praimondo1970-MyGit/SmartKiln-Firmware/assets/SmartKiln_UI_Guia_Estilo.pdf

## Guía de Estilo – Interfaz SmartKiln

### Paleta de Colores

La interfaz combina tonos oscuros con acentos cálidos y contrastantes. Se prioriza la legibilidad y el aspecto profesional.
Color | Código HEX | Uso
Fondo principal | #0D1117 | Color de fondo general
Tarjeta | #161B22 | Panel o tarjeta de información
Texto principal | #FFFFFF | Datos principales (temperatura, títulos)
Texto secundario | #A1A1A1 | Subtítulos, etiquetas
Acento (naranja) | #FF6B2C | Indicadores activos y barras de progreso
Acento alternativo (azul) | #0094FF | Modo alternativo o estado neutro

### Tipografía

Fuente principal: **Poppins / Montserrat** (sans-serif). Elegida por su legibilidad y estilo moderno, con curvas suaves que acompañan el diseño minimalista.
- Títulos y encabezados: Poppins Bold, 20–24 pt • Texto principal: Poppins Regular, 14–16 pt • Texto secundario o etiquetas: Poppins Light, 12–14 pt

### Componentes y Estructura Visual

- Tarjetas con bordes redondeados (radio: 10–12 px) y sombra sutil. • Gráficos de progreso circulares y lineales con degradado suave. • Iconografía monocromática en escala de grises. • Distribución: panel superior con nombre del dispositivo e íconos de conexión, zona central con temperatura y estado, zona inferior con detalles del proceso.

### Recomendaciones de Uso

- Mantener el contraste entre texto y fondo para asegurar la legibilidad. • Utilizar los colores de acento solo para destacar elementos clave. • Respetar márgenes y proporciones para preservar el equilibrio visual. • Preferir íconos minimalistas y consistentes con la paleta general.
