praimondo1970-MyGit/SmartKiln-Firmware/Circuito de Potencia/Conexiones_Fisicas_Potencia.png

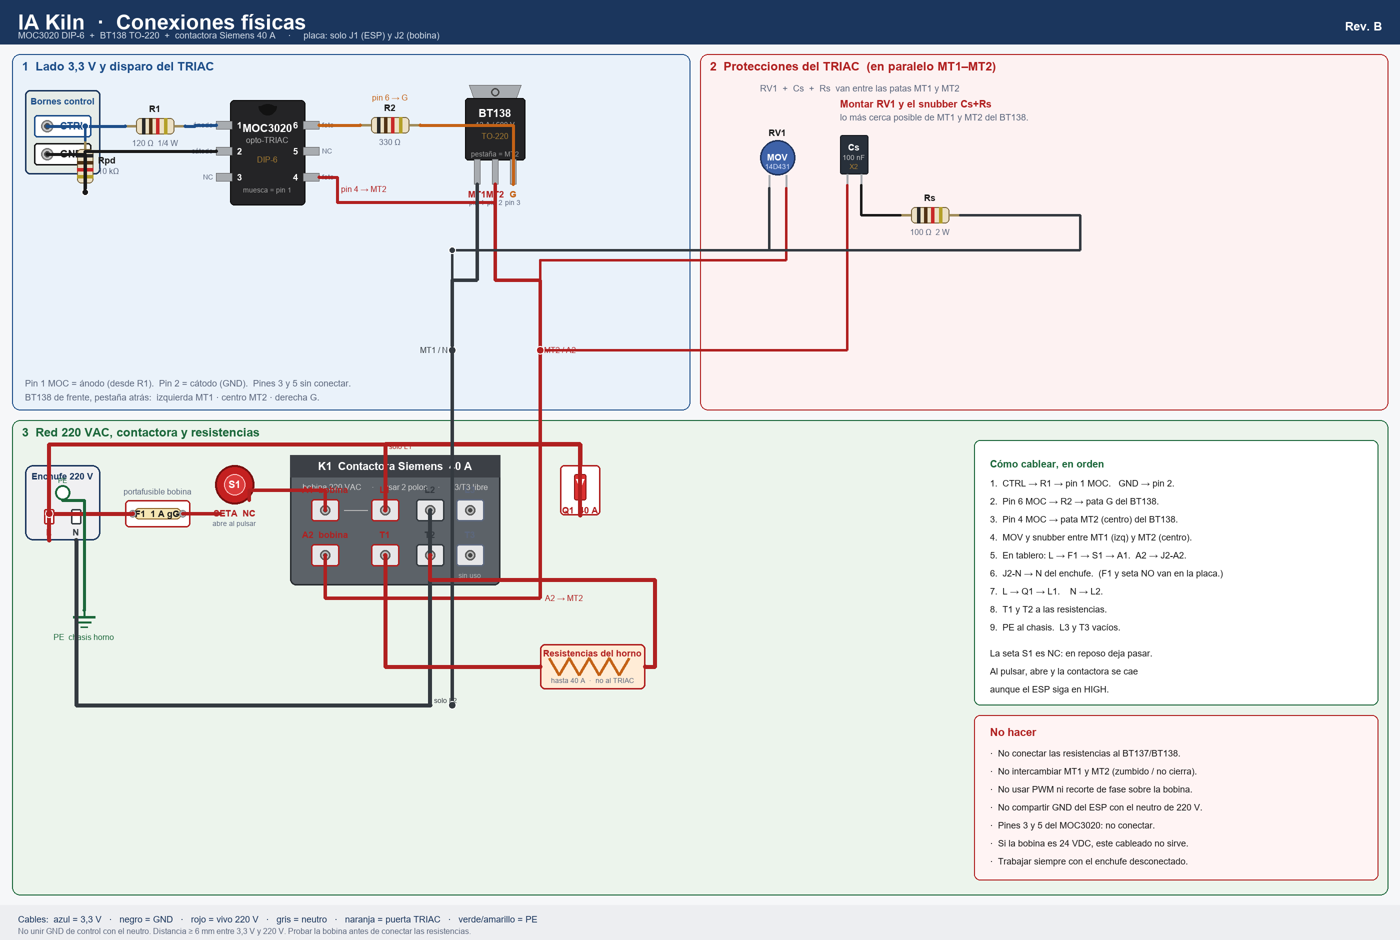
Circuito de Potencia/Conexiones_Fisicas_Potencia.png
