praimondo1970-MyGit/SmartKiln-Firmware/Display/c__Users_praim_AppData_Roaming_Cursor_User_workspaceStorage_e96c1dd4c59a7dd403c3e120ff3f4726_images_smartkiln-display-mockup-v2-dashboard-1fecc456-dbc0-4168-bc59-79bc5c1a509b.jpg

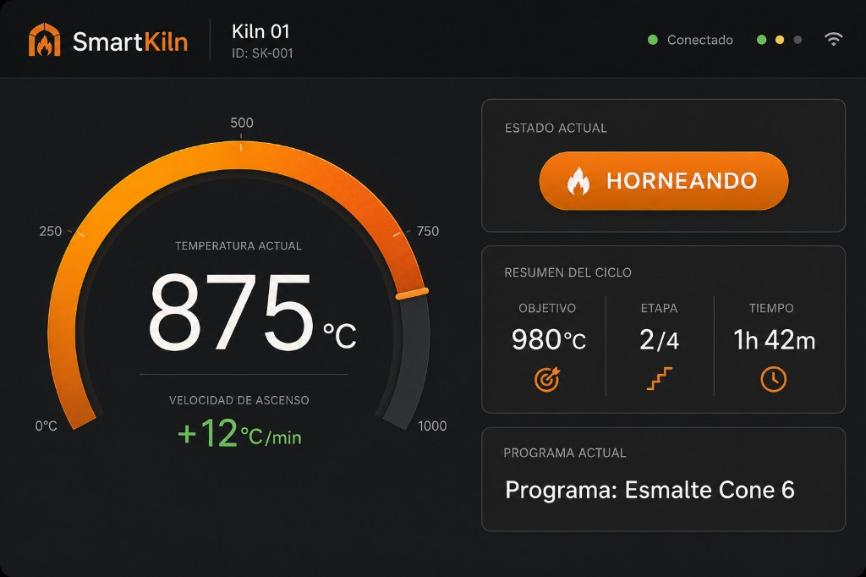
Display/c__Users_praim_AppData_Roaming_Cursor_User_workspaceStorage_e96c1dd4c59a7dd403c3e120ff3f4726_images_smartkiln-display-mockup-v2-dashboard-1fecc456-dbc0-4168-bc59-79bc5c1a509b.jpg
