praimondo1970-MyGit/SmartKiln-Firmware/Display/FINAL - Display.png

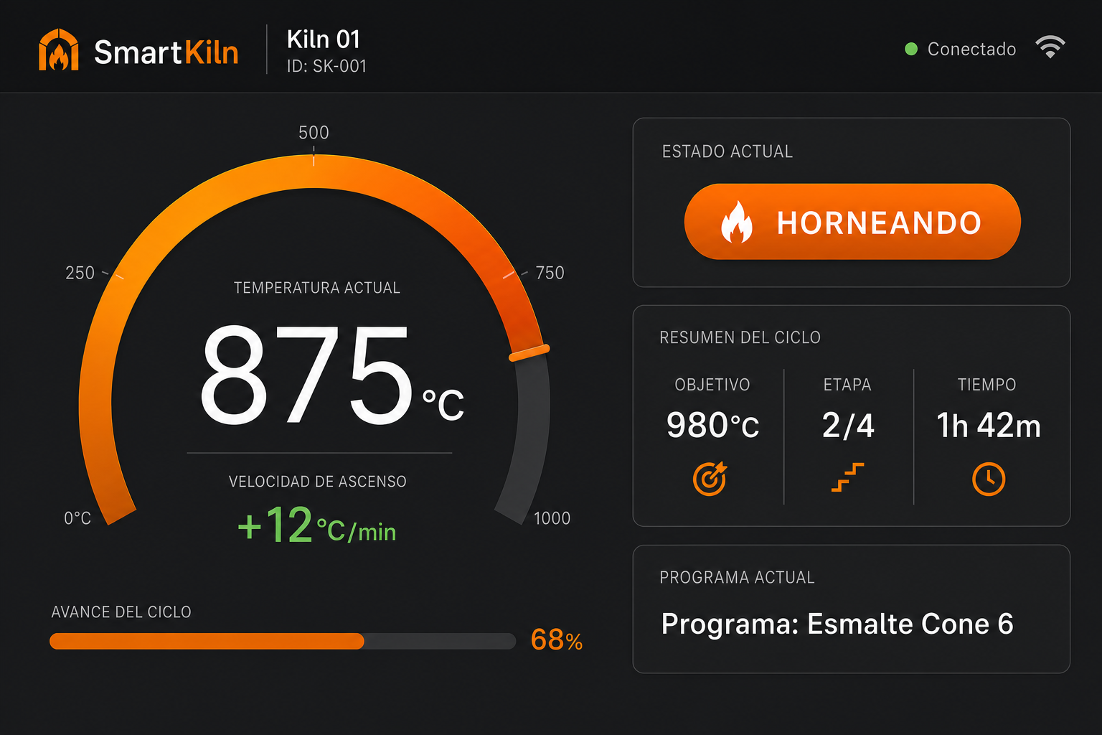
Display/FINAL - Display.png
