praimondo1970-MyGit/SmartKiln-Firmware/Display/FINAL - Inicio.png

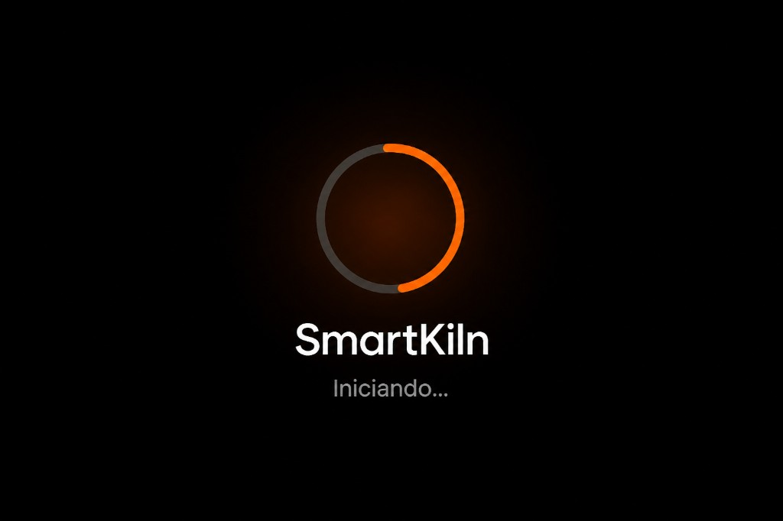
Display/FINAL - Inicio.png
