praimondo1970-MyGit/SmartKiln-Firmware/Display/smartkiln-display-mockup-v1-main.png

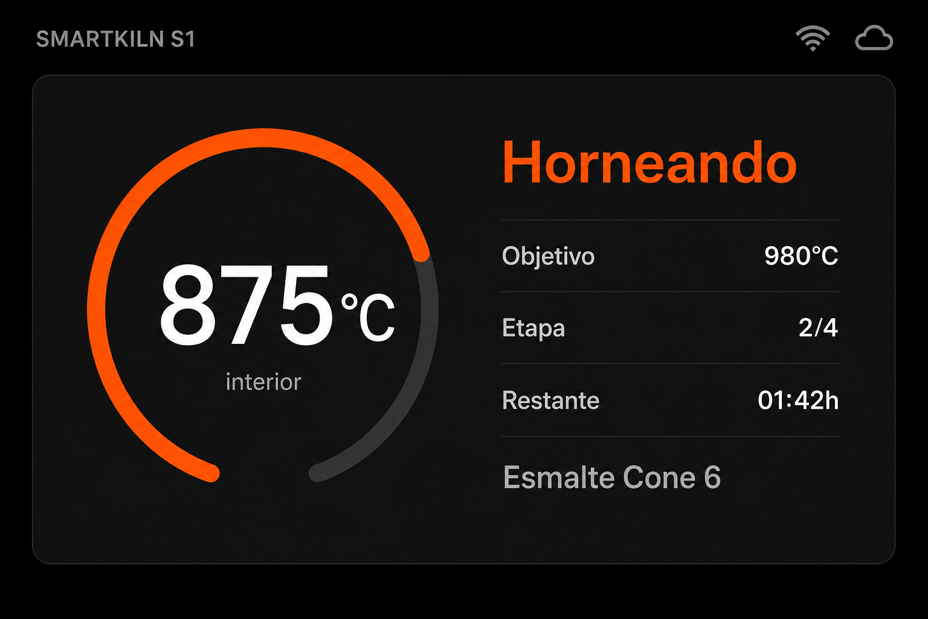
Display/smartkiln-display-mockup-v1-main.png
