praimondo1970-MyGit/SmartKiln-Firmware/Display/smartkiln-display-mockup-v2-dashboard.png

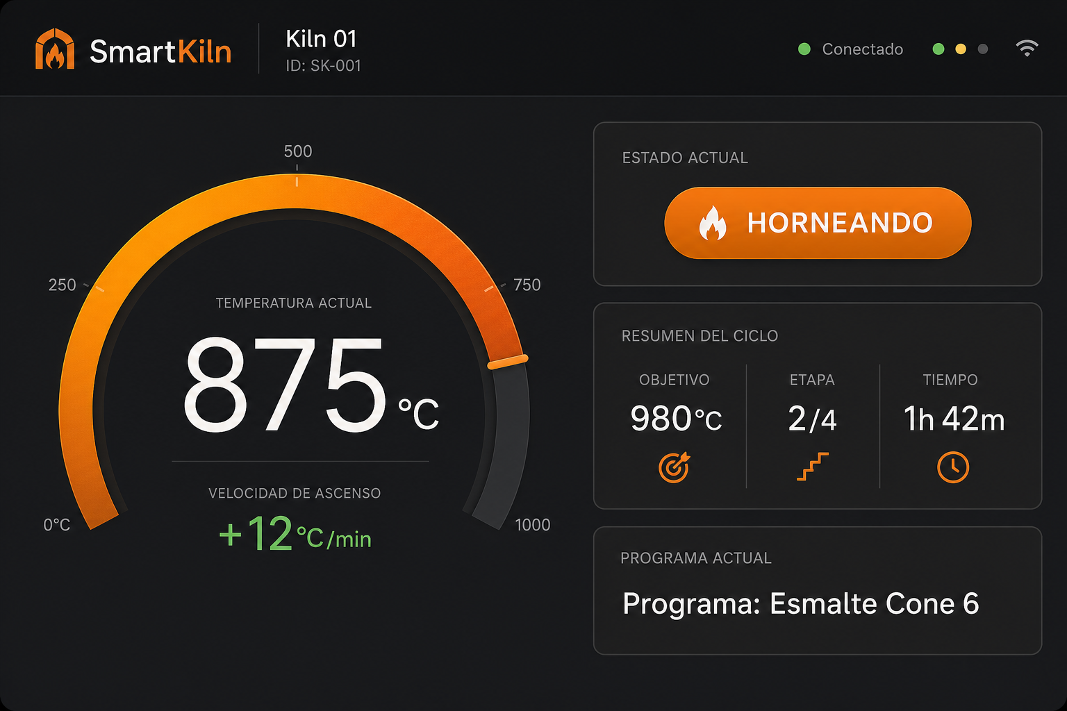
Display/smartkiln-display-mockup-v2-dashboard.png
