praimondo1970-MyGit/SmartKiln-Firmware/Display/smartkiln-display-mockup-v2-final-progress-compact.png

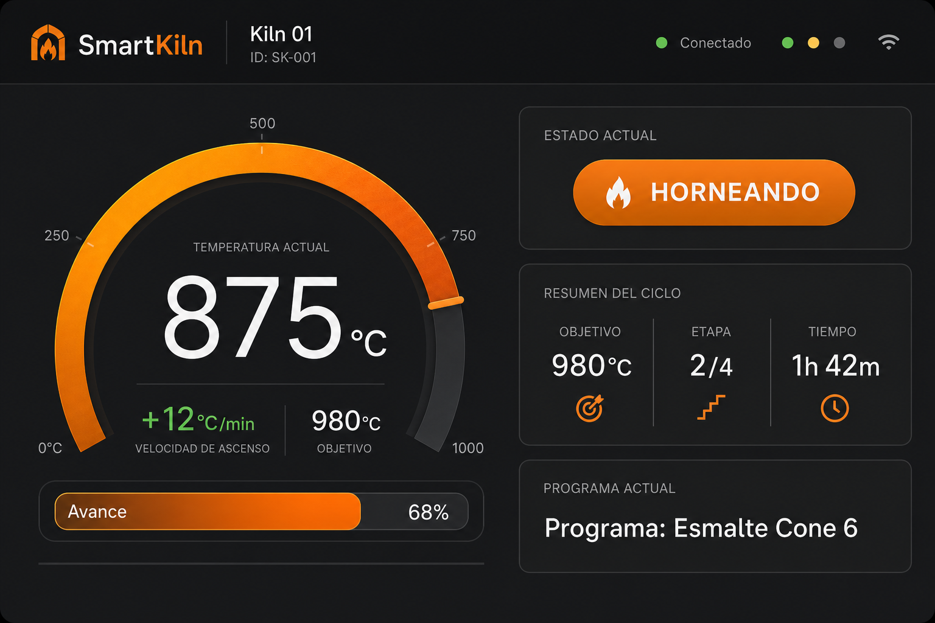
Display/smartkiln-display-mockup-v2-final-progress-compact.png
