praimondo1970-MyGit/SmartKiln-Firmware/Display/smartkiln-display-mockup-v2b-semicircle-cards.png

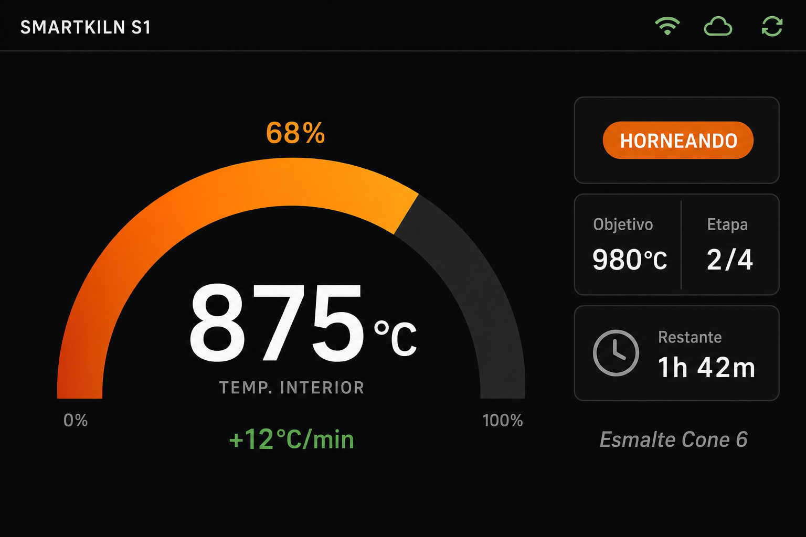
Display/smartkiln-display-mockup-v2b-semicircle-cards.png
