praimondo1970-MyGit/SmartKiln-Firmware/Display/smartkiln-display-mockup-v2c-tiles-hero.png

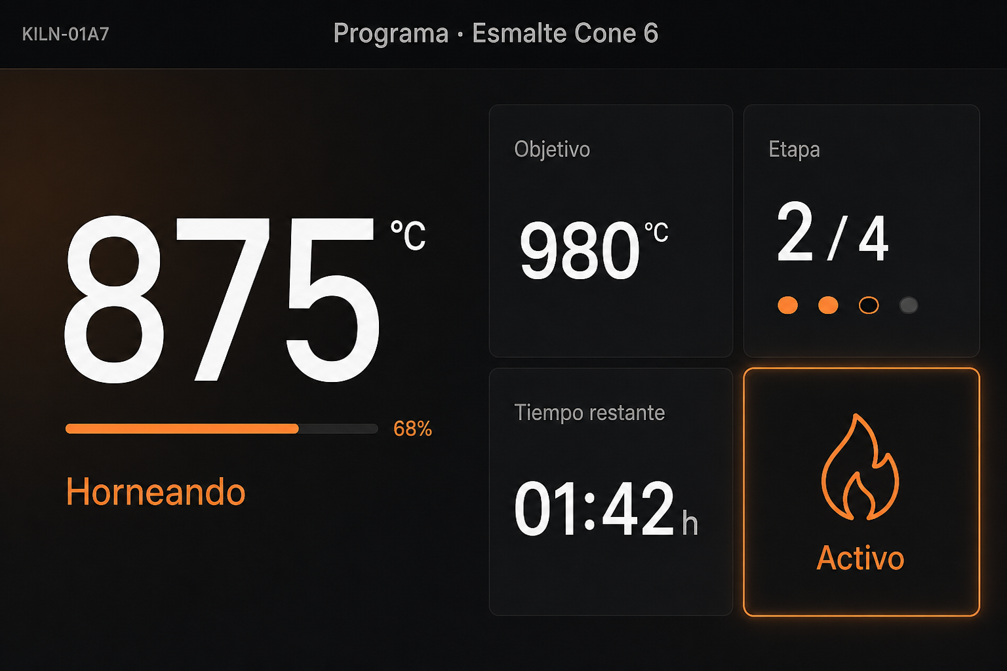
Display/smartkiln-display-mockup-v2c-tiles-hero.png
