praimondo1970-MyGit/SmartKiln-Firmware/docs/IA_Kiln_Driver_Cotas_1a1.png

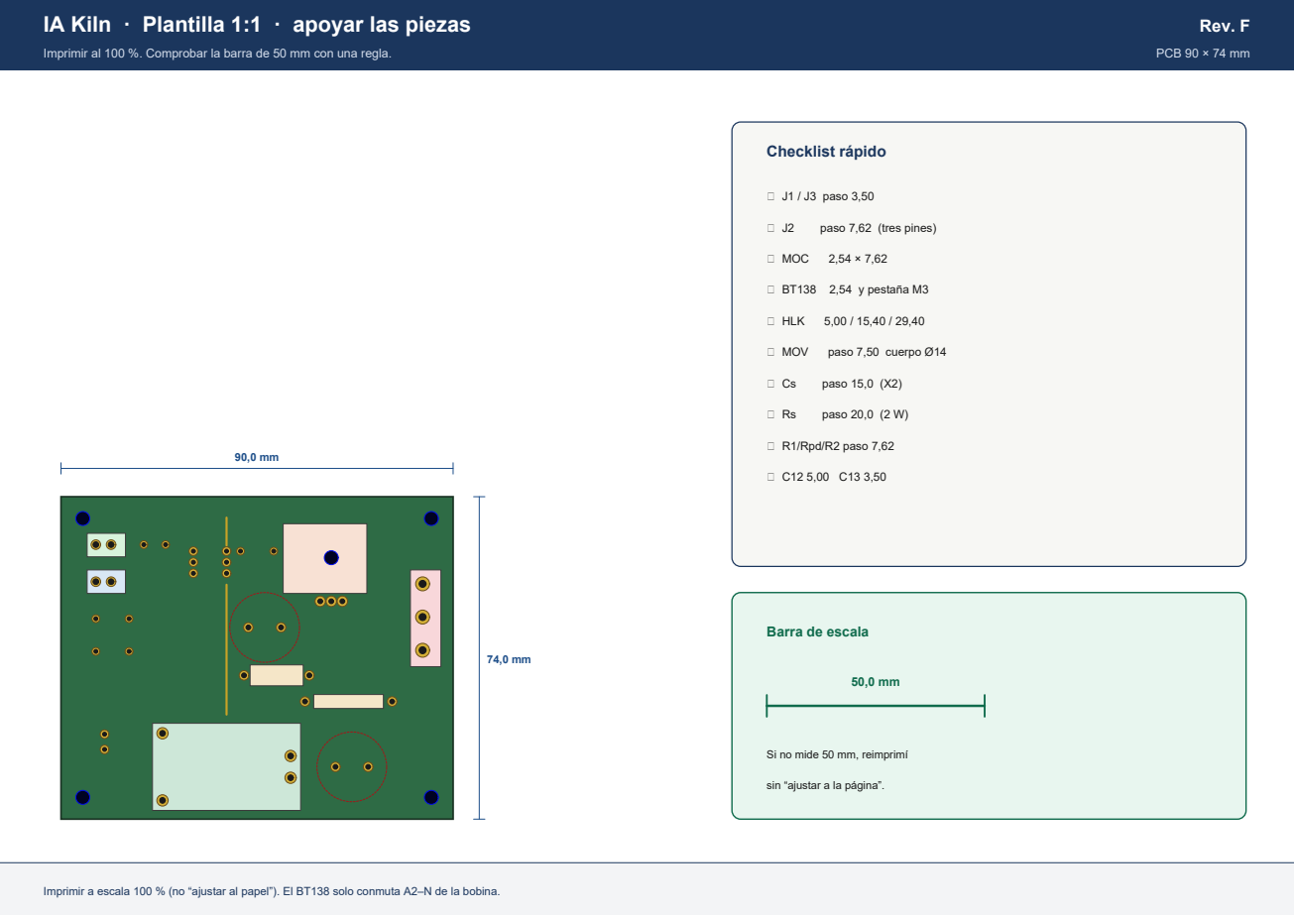
docs/IA_Kiln_Driver_Cotas_1a1.png
