praimondo1970-MyGit/SmartKiln-Firmware/docs/IA_Kiln_Driver_Cotas_2026-09-06_p2.png

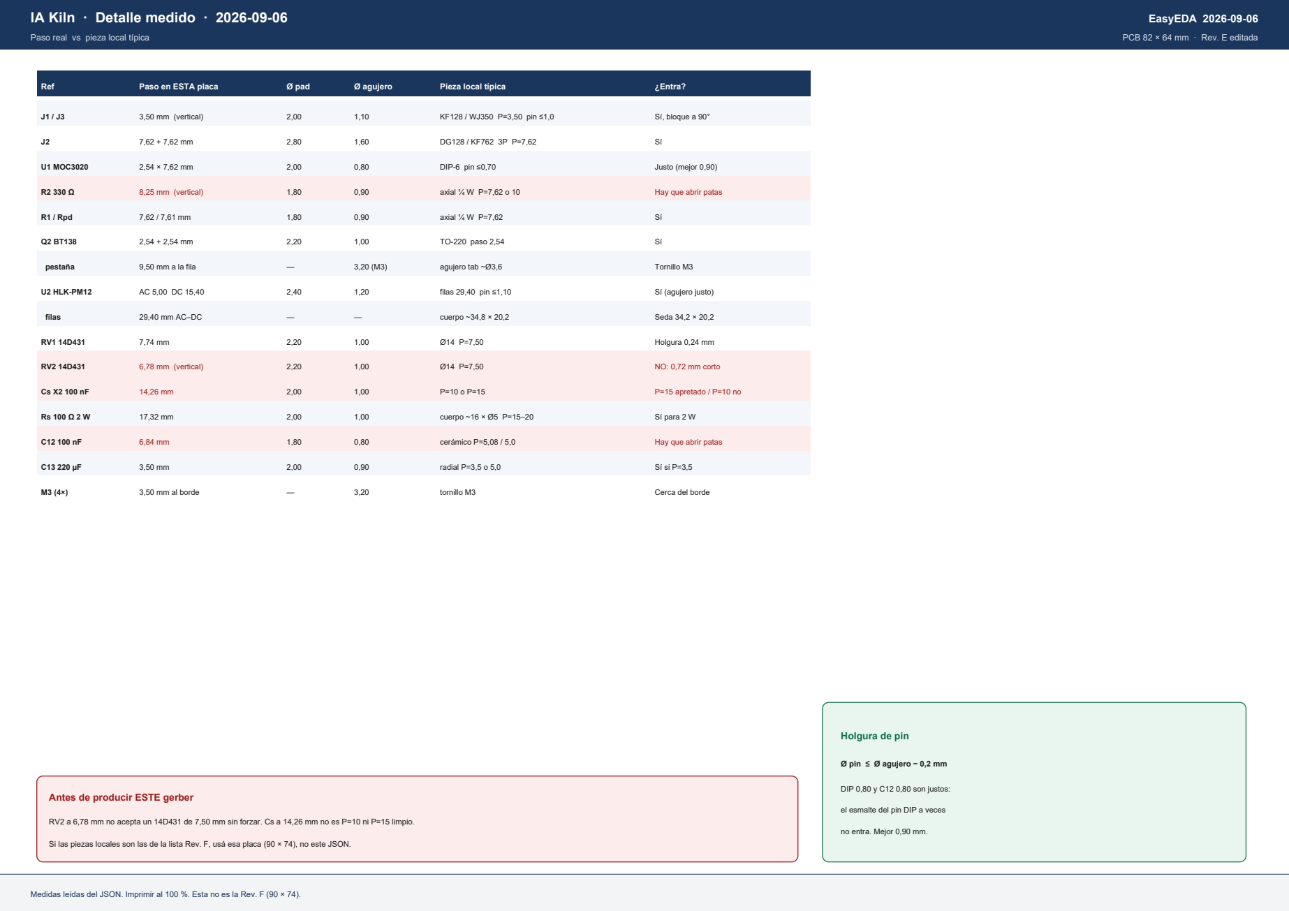
docs/IA_Kiln_Driver_Cotas_2026-09-06_p2.png
