praimondo1970-MyGit/SmartKiln-Firmware/docs/IA_Kiln_Driver_Esquema_p1.png

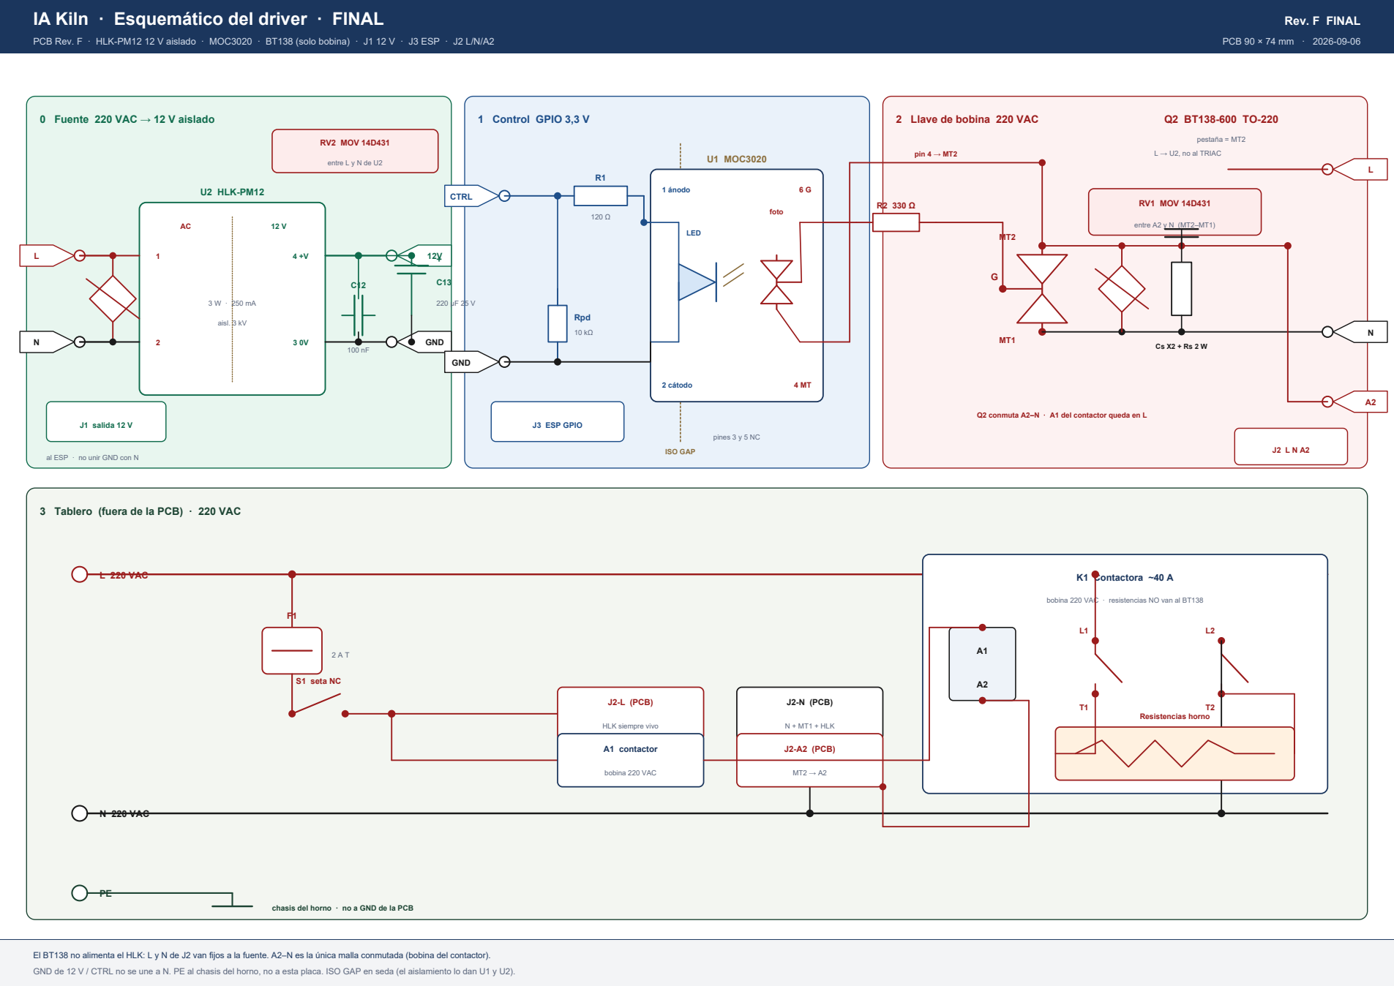
docs/IA_Kiln_Driver_Esquema_p1.png
