praimondo1970-MyGit/SmartKiln-Firmware/pcb/IA_Kiln_Driver_3D.png

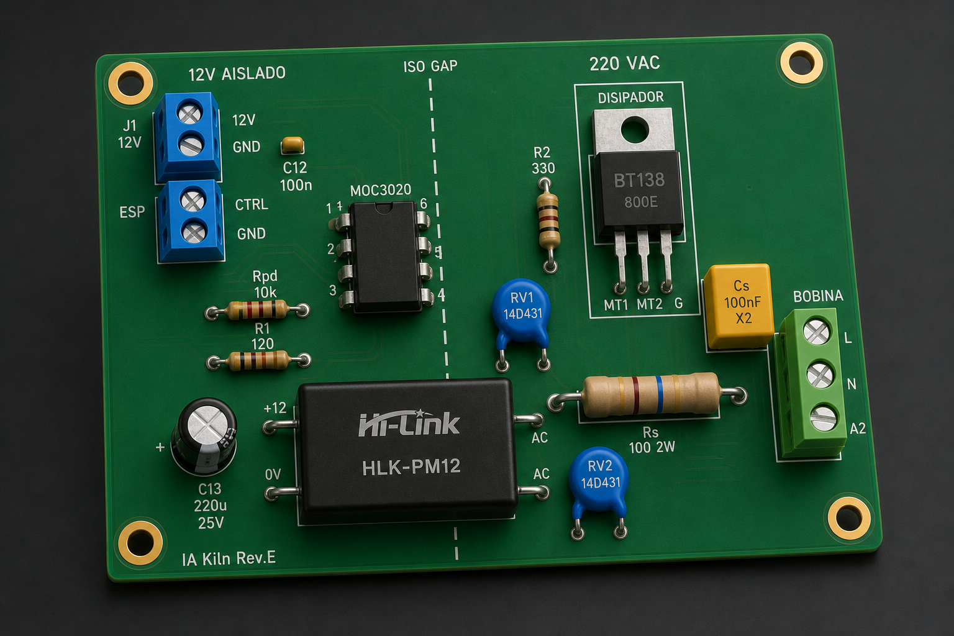
pcb/IA_Kiln_Driver_3D.png
