praimondo1970-MyGit/SmartKiln-Firmware/pcb/IA_Kiln_Driver_PCB_preview.png

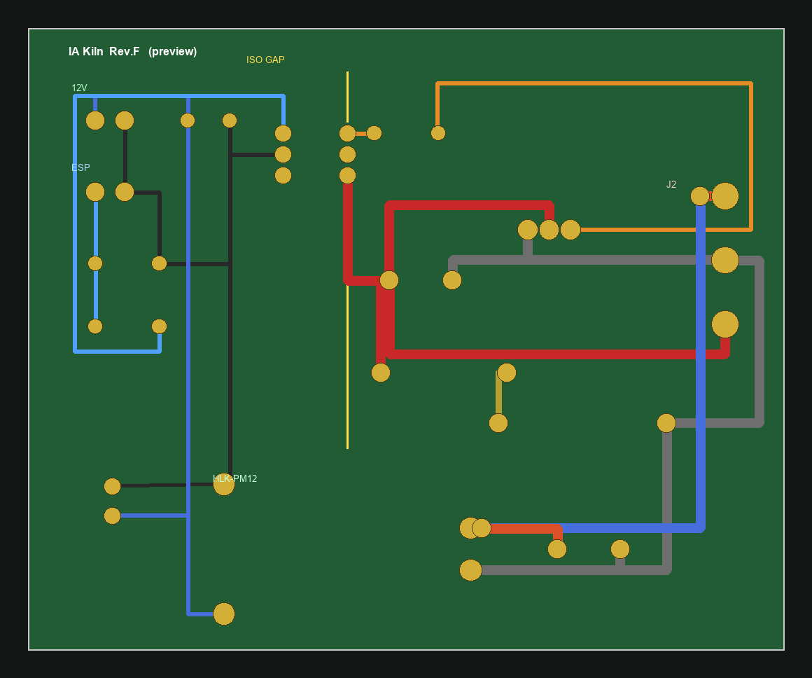
pcb/IA_Kiln_Driver_PCB_preview.png
