praimondo1970-MyGit/SmartKiln-Firmware/docs/IA_Kiln_Driver_BOM.xlsx

Grupo | Cant. | Ref | Componente | Valor / tipo | Función | Enlace
PCB | 1 | U2 | Fuente AC/DC | HLK-PM12 12 V / 3 W | 220 VAC → 12 V aislado para el ESP | https://www.lcsc.com/product-detail/New-Arrivals_HI-LINK-HLK-PM12_C209905.html
PCB | 1 | C12 | Capacitor | 100 nF (paso 5 mm) | Desacople de 12 V
PCB | 1 | C13 | Electrolítico | 220 µF 25 V paso 3,5 mm | Filtro de salida HLK
PCB | 1 | RV2 | Varistor | 14D431K MOV Ø14 mm 430 V paso 7,5 mm | Entre L y N de U2 | https://www.lcsc.com/product-detail/Varistors_Hongzhi-Elec-14D431K_C137830.html
PCB | 1 | J1 | Borne PCB | 2 polos 3,5 mm 12 V / GND | Salida 12 V al ESP (aislado) | https://www.lcsc.com/product-detail/C474930.html
PCB | 1 | J3 | Borne PCB | 2 polos 3,5 mm CTRL / GND | GPIO 3,3 V activo HIGH | https://www.lcsc.com/product-detail/C474930.html
PCB | 1 | R1 | Resistencia | 120 Ω 1/4 W paso 7,62 mm | LED del MOC3020 (~17 mA a 3,3 V)
PCB | 1 | Rpd | Resistencia | 10 kΩ 1/4 W paso 7,62 mm | Pull-down de CTRL en el reset
PCB | 1 | U1 | Optoacoplador | MOC3020 DIP-6 | Aislamiento y disparo del TRIAC
PCB | 1 | R2 | Resistencia | 330 Ω 1/4 W paso 7,62 mm | Puerta del BT138
PCB | 1 | Q2 | TRIAC | BT138-600 TO-220 | Llave de la bobina. Pestaña = MT2 | https://www.lcsc.com/product-detail/TRIACs_JSMSEMI-BT138-600E_C916559.html
PCB | 1 | RV1 | Varistor | 14D431K MOV Ø14 mm 430 V paso 7,5 mm | Entre A2 y N, junto al BT138 | https://www.lcsc.com/product-detail/Varistors_Hongzhi-Elec-14D431K_C137830.html
PCB | 1 | Cs | Capacitor X2 | 100 nF 275 VAC P=15 mm | Snubber, en serie con Rs
PCB | 1 | Rs | Resistencia | 100 Ω 2 W P=20 mm | Snubber entre MT1 y MT2
PCB | 1 | J2 | Borne PCB | 3 polos 7,62 mm L / N / A2 | Red y bobina. L no pasa por Q2 | https://www.lcsc.com/product-detail/C475105.html
PCB | 1 | — | PCB | 90 × 74 mm Rev. F 4× M3 | Placa del driver
PCB | 1 | — | Disipador TO-220 | con tornillo M3 (pestaña = MT2 = 220 V) | Refrigerar el BT138
Tablero | 1 | F1 | Fusible + portafusible | 2 A T 250 V | Inrush del HLK + bobina
Tablero | 1 | S1 | Seta de emergencia | NC 220 VAC | Corta L a J2-L y a A1
Tablero | 1 | K1 | Contactora | Siemens ~40 A, bobina 220 V | Resistencias del horno. No al TRIAC
Tablero | 1 | — | Cableado 220 | L, N, PE al chasis del horno | PE nunca al GND del ESP
Control | 1 | — | Panel ESP32 | ESP32-4827S043 (o el ESP que uses) | Control del horno
Control | 1 | — | Buck 12 V → 5 V | el HLK entrega 12 V; el panel suele ser 5 V | Alimentar el ESP
Mecánica | 4 | — | Tornillo M3 | con tuerca / separador | Fijar la PCB (5 mm del borde)
Mecánica | 1 | — | Caja / tablero cerrado | aislación 220 VAC | Montaje seguro
