praimondo1970-MyGit/SmartKiln-Firmware/cad/enclosure/SmartKiln_Caja.FCStd

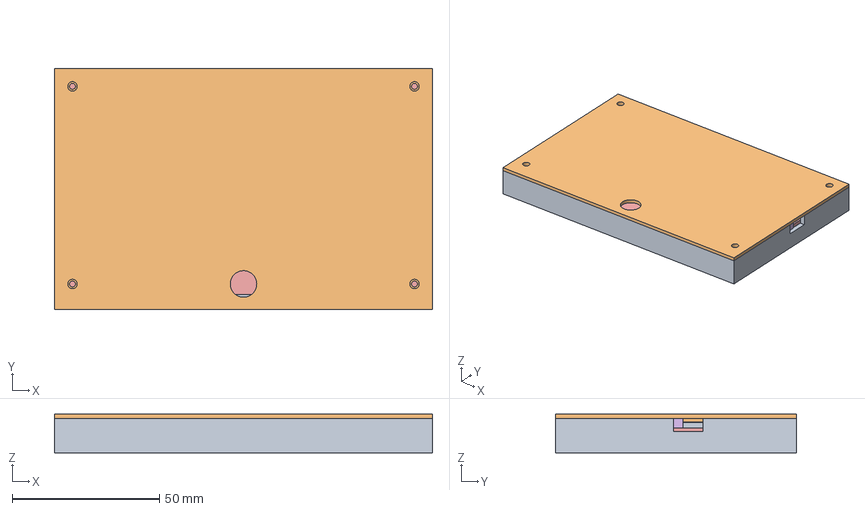
[picture p50: CAD file, 2026-09-07]
cad/enclosure/SmartKiln_Caja.FCStd
128.2 x 81.8 x 13.2 mm
Frente
Fondo
Ref_Vidrio
Ref_LCD
Ref_PCB
Ref_USB
