praimondo1970-MyGit/SmartKiln-Firmware/cad/enclosure/SmartKiln_Frente.step

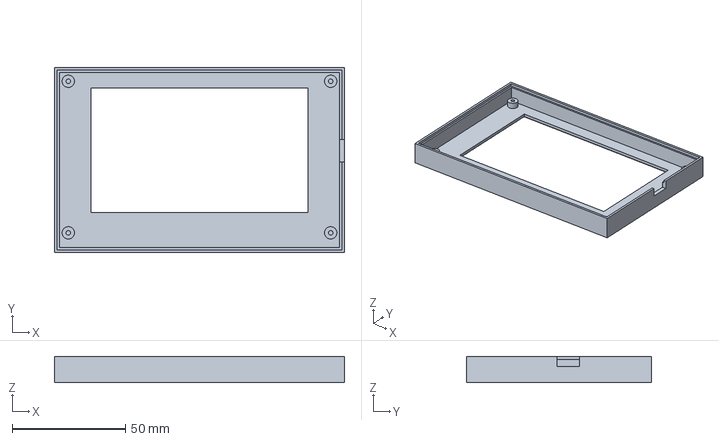
[picture p51: CAD file, 2026-09-07]
cad/enclosure/SmartKiln_Frente.step
128.2 x 81.8 x 11.7 mm
