praimondo1970-MyGit/SmartKiln-Firmware/cad/enclosure/SmartKiln_Fondo.step

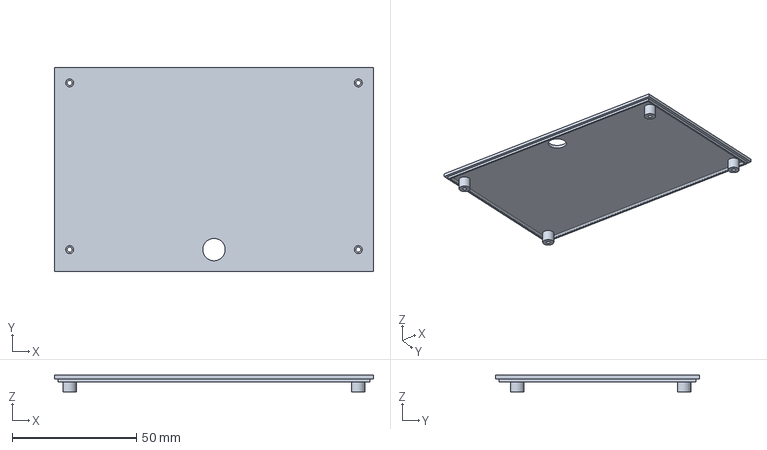
[picture p52: CAD file, 2026-09-07]
cad/enclosure/SmartKiln_Fondo.step
128.2 x 81.8 x 6.70 mm
