praimondo1970-MyGit/SmartKiln-Firmware/(list of files, cad)

Other CAD files:
cad/enclosure/SmartKiln_Fondo.stl
cad/enclosure/SmartKiln_Frente.stl
