praimondo1970-MyGit/SmartKiln-Firmware/docs/Prueba_MOC_BTA_Montaje.png

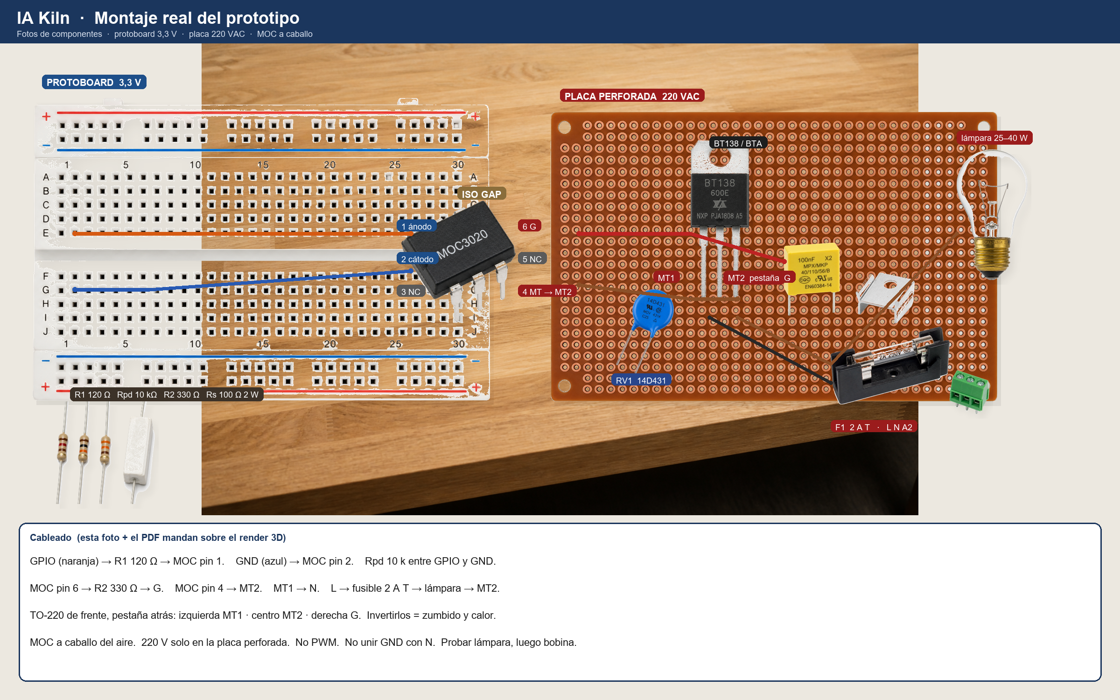
docs/Prueba_MOC_BTA_Montaje.png
