praimondo1970-MyGit/SmartKiln-Firmware/docs/Prueba_MOC_BTA_3D.png

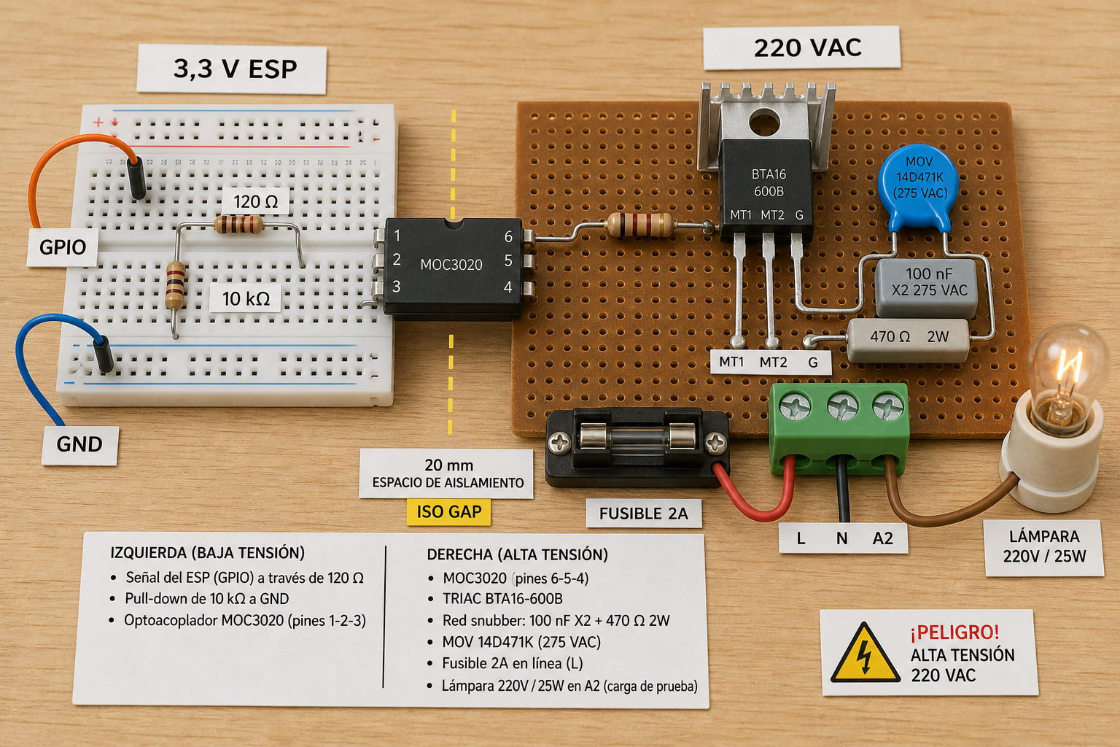
docs/Prueba_MOC_BTA_3D.png
