praimondo1970-MyGit/SmartKiln-Firmware/docs/Prueba_MOC_BTA_Esquema.pdf

# IA Kiln · Prototipo casero · MOC3020 + BT138 / BTA

## Rev. A2

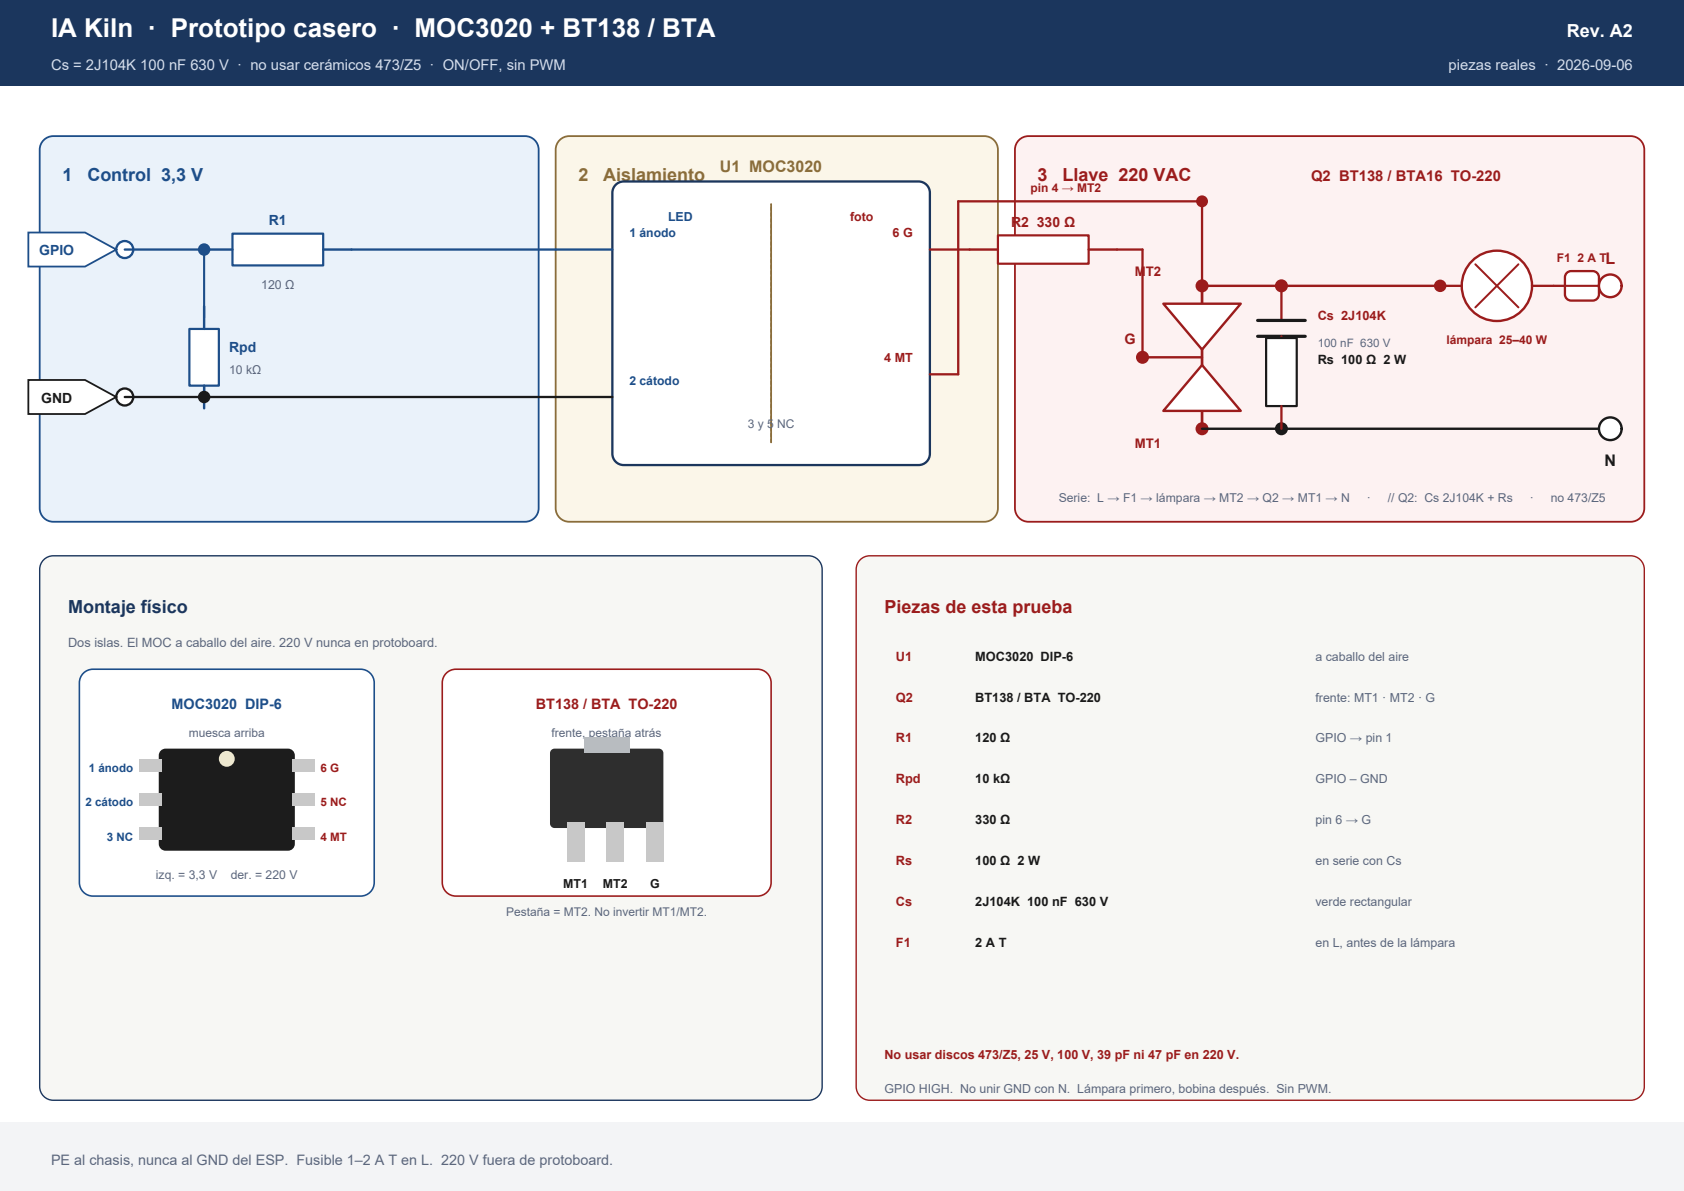
[picture p55: page 1]
piezas reales · 2026-09-06; 1 Control 3,3 V; 2 Aislamiento; 3 Llave 220 VAC; GPIO; GND; Rpd; U1 MOC3020; LED; foto; 1 ánodo; 2 cátodo; Q2 BT138 / BTA16 TO-220; pin 4 → MT2; lámpara 25–40 W; Serie: L → F1 → lámpara → MT2 → Q2 → MT1 → N; Montaje físico; MOC3020 DIP-6; muesca arriba; izq. = 3,3 V der. = 220 V; BT138 / BTA TO-220; a caballo del aire; frente: MT1 · MT2 · G; GPIO → pin 1; GPIO – GND; pin 6 → G; en serie con Cs; verde rectangular; en L, antes de la lámpara

Cs = 2J104K 100 nF 630 V · no usar cerámicos 473/Z5 · ON/OFF, sin PWM

Piezas de esta prueba

Dos islas. El MOC a caballo del aire. 220 V nunca en protoboard.

frente, pestaña atrás

Pestaña = MT2. No invertir MT1/MT2.

No usar discos 473/Z5, 25 V, 100 V, 39 pF ni 47 pF en 220 V.

GPIO HIGH. No unir GND con N. Lámpara primero, bobina después. Sin PWM.

PE al chasis, nunca al GND del ESP. Fusible 1–2 A T en L. 220 V fuera de protoboard.
