praimondo1970-MyGit/SmartKiln-Firmware/Circuito de Potencia/Circuito_Potencia_Horno.pdf

# IA Kiln · Circuito de potencia

## Rev. A

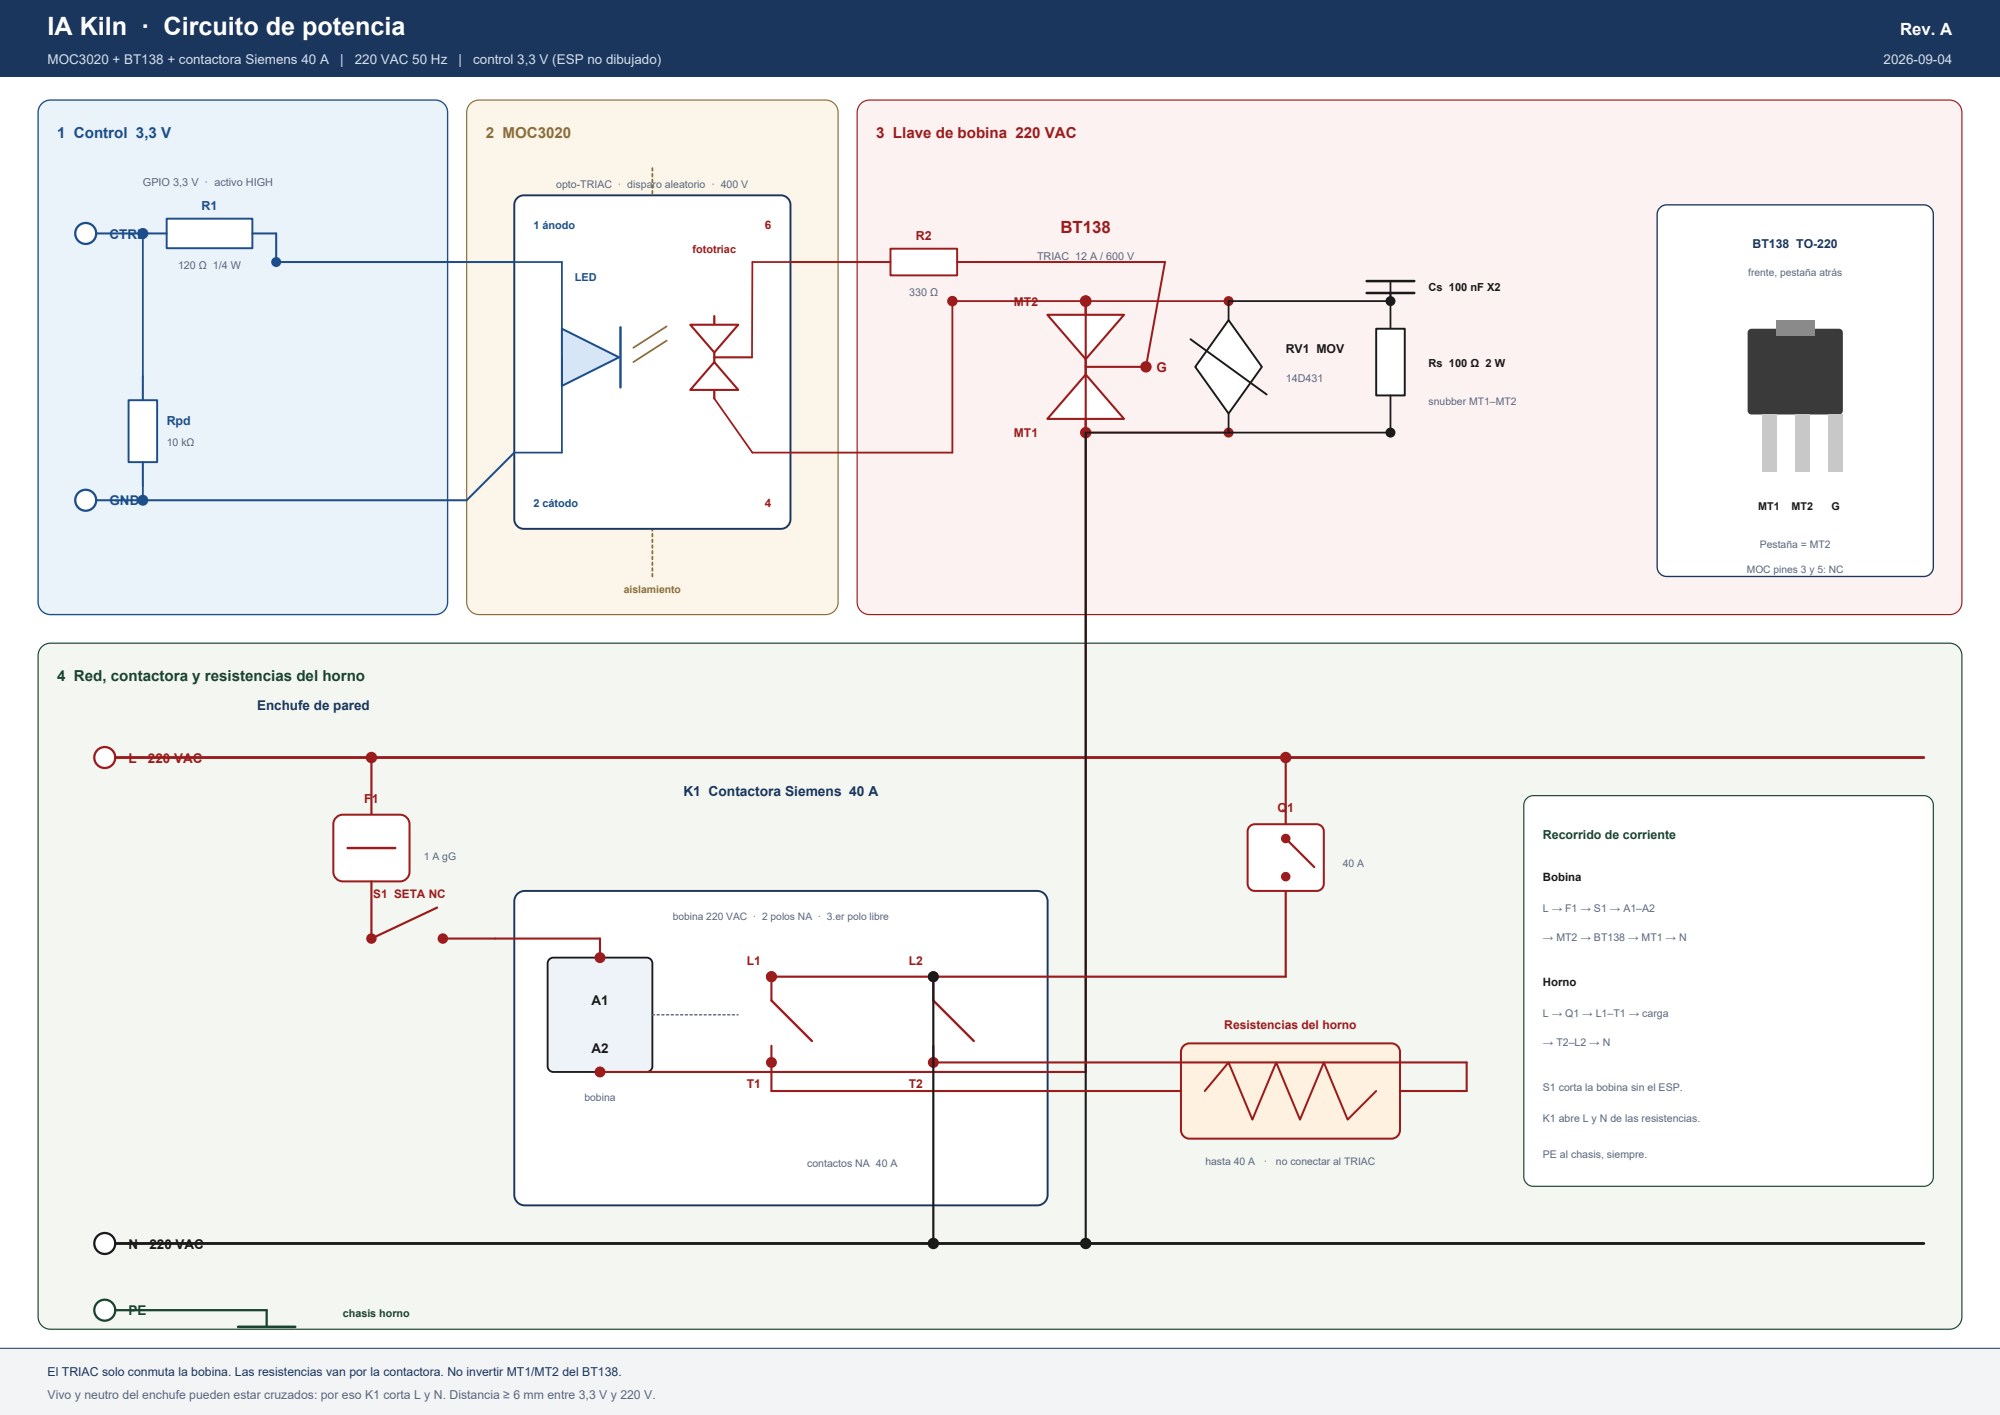
[picture p56: page 1]
1 Control 3,3 V; 2 MOC3020; 3 Llave de bobina 220 VAC; aislamiento; CTRL; GND; Rpd; LED; 1 ánodo; 2 cátodo; fototriac; TRIAC 12 A / 600 V; RV1 MOV; snubber MT1–MT2; Pestaña = MT2; L 220 VAC; N 220 VAC; chasis horno; S1 SETA NC; K1 Contactora Siemens 40 A; bobina; contactos NA 40 A; Bobina; Horno; L → Q1 → L1–T1 → carga

MOC3020 + BT138 + contactora Siemens 40 A | 220 VAC 50 Hz | control 3,3 V (ESP no dibujado)

GPIO 3,3 V · activo HIGH

opto-TRIAC · disparo aleatorio · 400 V

frente, pestaña atrás

MOC pines 3 y 5: NC

4 Red, contactora y resistencias del horno

Enchufe de pared

Recorrido de corriente

bobina 220 VAC · 2 polos NA · 3.er polo libre

Resistencias del horno

S1 corta la bobina sin el ESP.

K1 abre L y N de las resistencias.

hasta 40 A · no conectar al TRIAC

PE al chasis, siempre.

El TRIAC solo conmuta la bobina. Las resistencias van por la contactora. No invertir MT1/MT2 del BT138.

Vivo y neutro del enchufe pueden estar cruzados: por eso K1 corta L y N. Distancia ≥ 6 mm entre 3,3 V y 220 V.

# IA Kiln · Materiales y montaje

Circuito de potencia · MOC3020 + BT138 + contactora 40 A

## Rev. A

2026-09-04

Probar primero la bobina sola, con las resistencias del horno desconectadas.

Ref | Componente | Valor / tipo | Función
R1 | Resistencia | 120 Ω 1/4 W | LED del MOC3020 (~17 mA a 3,3 V)
Rpd | Resistencia | 10 kΩ 1/4 W | Pull-down: CTRL en 0 durante el reset
R2 | Resistencia | 330 Ω 1/4 W | Puerta del BT138
Rs | Resistencia | 100 Ω 2 W | Snubber, en serie con Cs entre MT1 y MT2
Cs | Capacitor | 100 nF X2 275 VAC | Snubber de la bobina (carga inductiva)
U1 | Optoacoplador | MOC3020 | Aislamiento y disparo aleatorio del TRIAC
Q2 | TRIAC | BT138-600 (TO-220) | Llave de la bobina. BT137 de reserva
RV1 | Varistor | MOV 14D431 | Absorbe picos al abrir la bobina
F1 | Fusible | 1 A gG | Protege solo el circuito de bobina
S1 | Seta NC | NC 220 VAC | Emergencia: corta la bobina sin el ESP
K1 | Contactora | Siemens ~40 A, bobina 220 VAC | 2 polos NA cortan L y N de las resistencias
Q1 | Termomagnética | 40 A curva C | Protección de las resistencias
— | Entrada red | L / N / PE 220 VAC | Enchufe doméstico; PE al chasis
— | Carga | Resistencias del horno | Nunca al BT137/BT138

## Montaje y uso

Lado izquierdo del MOC: solo 3,3 V. No unir GND del

control con el neutro de 220 V.

MOC3020 es de 400 V. En 220 VAC el pico es 311 V:

snubber y MOV no son opcionales.

Pinout BT138 (TO-220, frente, pestaña atrás):

izquierdo MT1 · centro MT2 · derecho G.

Si invertís MT1 y MT2, dispara un solo semiciclo:

zumbido, cierre incompleto, TRIAC caliente.

Vivo/neutro del enchufe no hace falta identificarlos

para el TRIAC. K1 corta los dos conductores.

Firmware: solo ON/OFF. Nada de PWM ni recorte de

fase. Ventana 15–20 s, mínimo 2 s por estado.

Poner CTRL en LOW antes de configurar el GPIO.

Si la bobina fuera 24 VDC este circuito no sirve:

usar MOSFET + diodo flyback.

S1 y Q1 deben apagar el horno aunque el ESP se

cuelgue o deje CTRL en 1.

### 220 VAC · peligro

Montar en tablero cerrado. PE al chasis del horno y a K1. No trabajar con la red conectada.

Probar la bobina sola antes de conectar las resistencias. El BT137 no entra en el esquema; es repuesto del BT138.

Pines MOC3020: 1 ánodo, 2 cátodo, 4 y 6 fototriac. Pines 3 y 5 sin conectar.
