praimondo1970-MyGit/SmartKiln-Firmware/docs/IA_Kiln_Driver_Cotas.pdf

# IA Kiln · Cotas de footprints · para piezas locales

## Rev. F

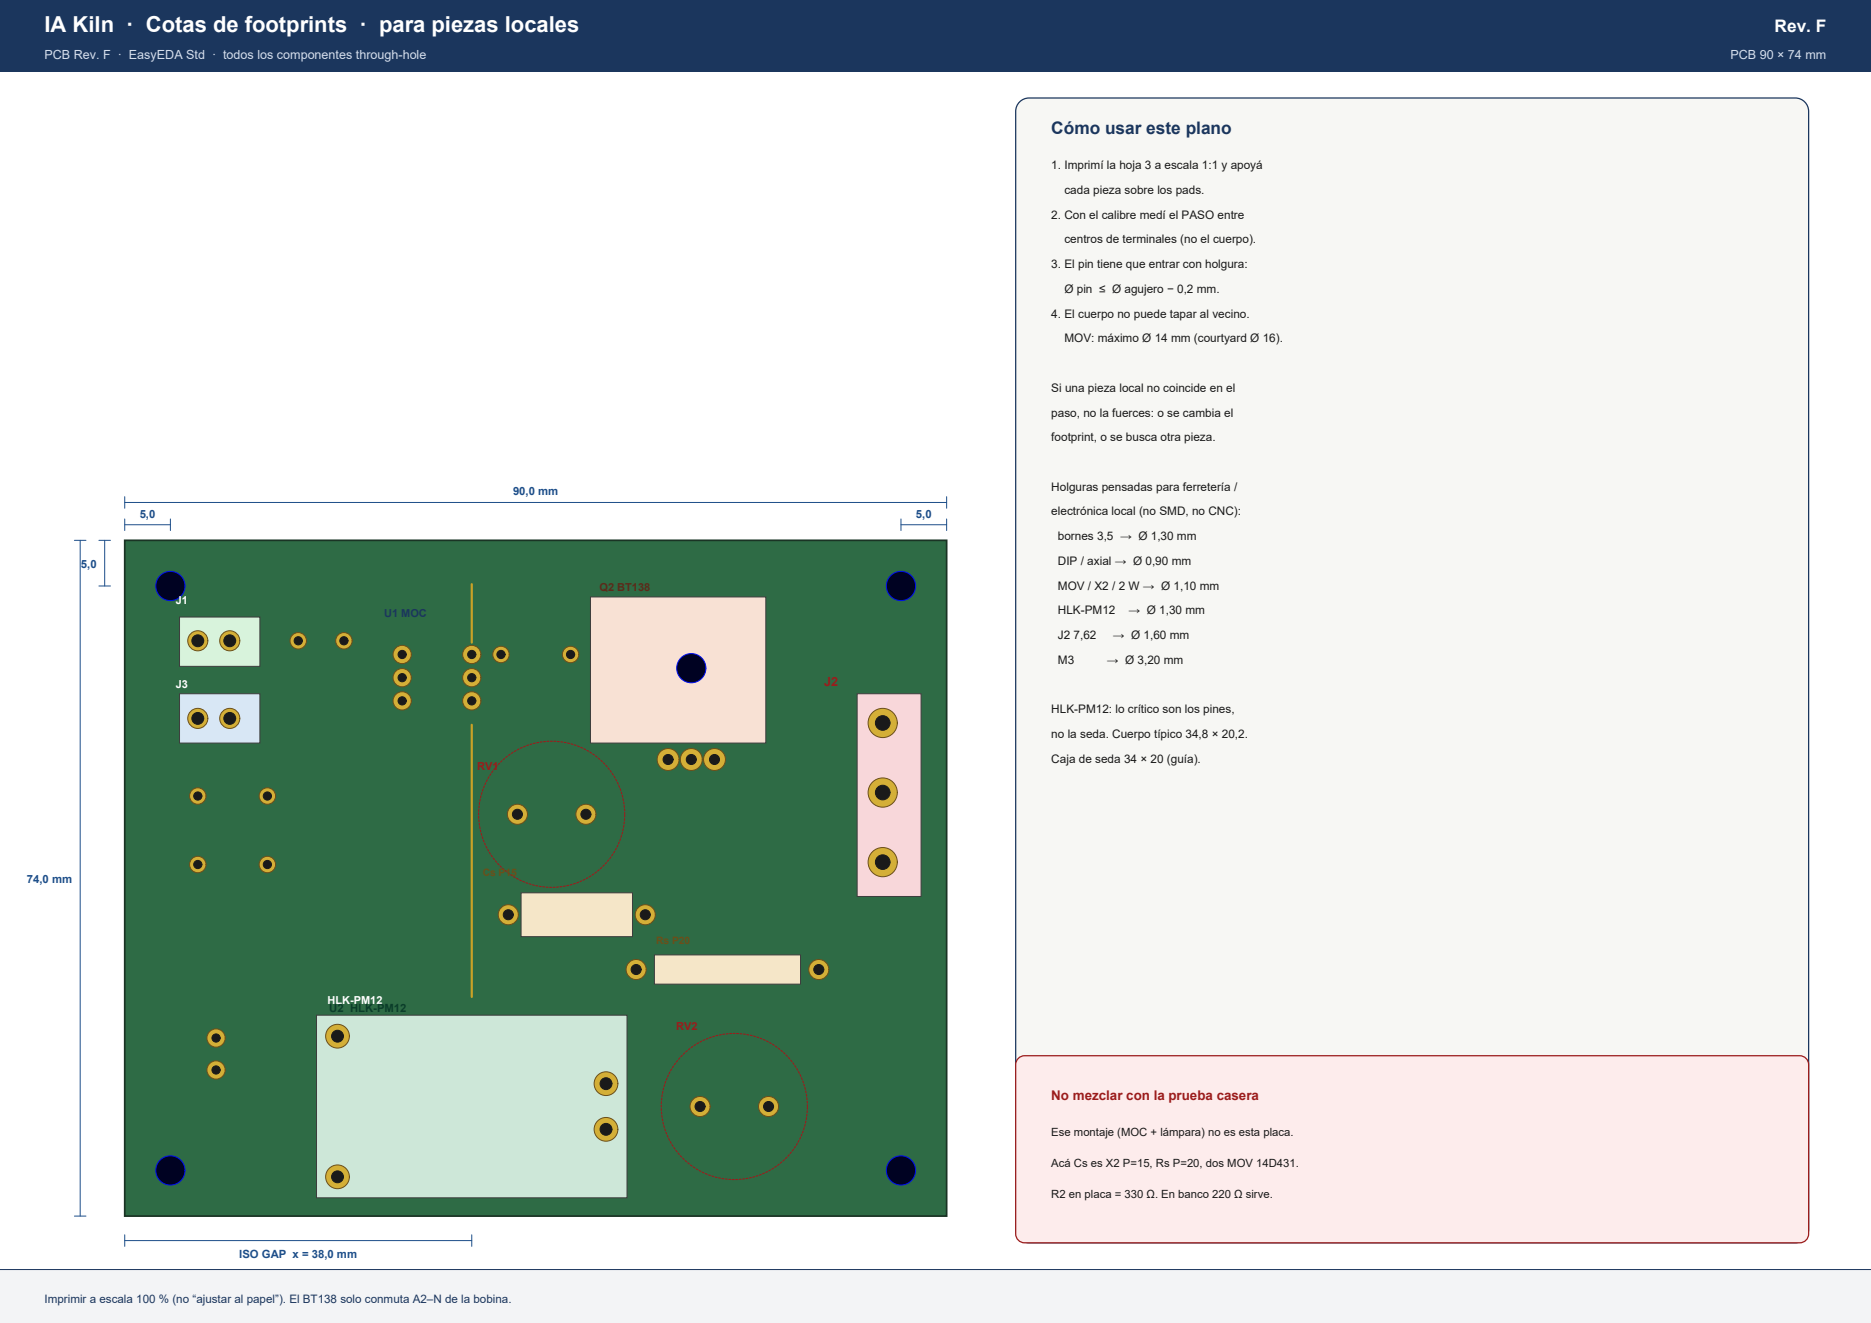
[picture p57: page 1]

PCB Rev. F · EasyEDA Std · todos los componentes through-hole

Cómo usar este plano

1. Imprimí la hoja 3 a escala 1:1 y apoyá

cada pieza sobre los pads.

2. Con el calibre medí el PASO entre

centros de terminales (no el cuerpo).

3. El pin tiene que entrar con holgura:

4. El cuerpo no puede tapar al vecino.

MOV: máximo Ø 14 mm (courtyard Ø 16).

Si una pieza local no coincide en el

paso, no la fuerces: o se cambia el

footprint, o se busca otra pieza.

Holguras pensadas para ferretería /

electrónica local (no SMD, no CNC):

HLK-PM12: lo crítico son los pines,

no la seda. Cuerpo típico 34,8 × 20,2.

Caja de seda 34 × 20 (guía).

No mezclar con la prueba casera

Ese montaje (MOC + lámpara) no es esta placa.

Acá Cs es X2 P=15, Rs P=20, dos MOV 14D431.

R2 en placa = 330 Ω. En banco 220 Ω sirve.

Imprimir a escala 100 % (no “ajustar al papel”). El BT138 solo conmuta A2–N de la bobina.

# IA Kiln · Detalle de cada footprint

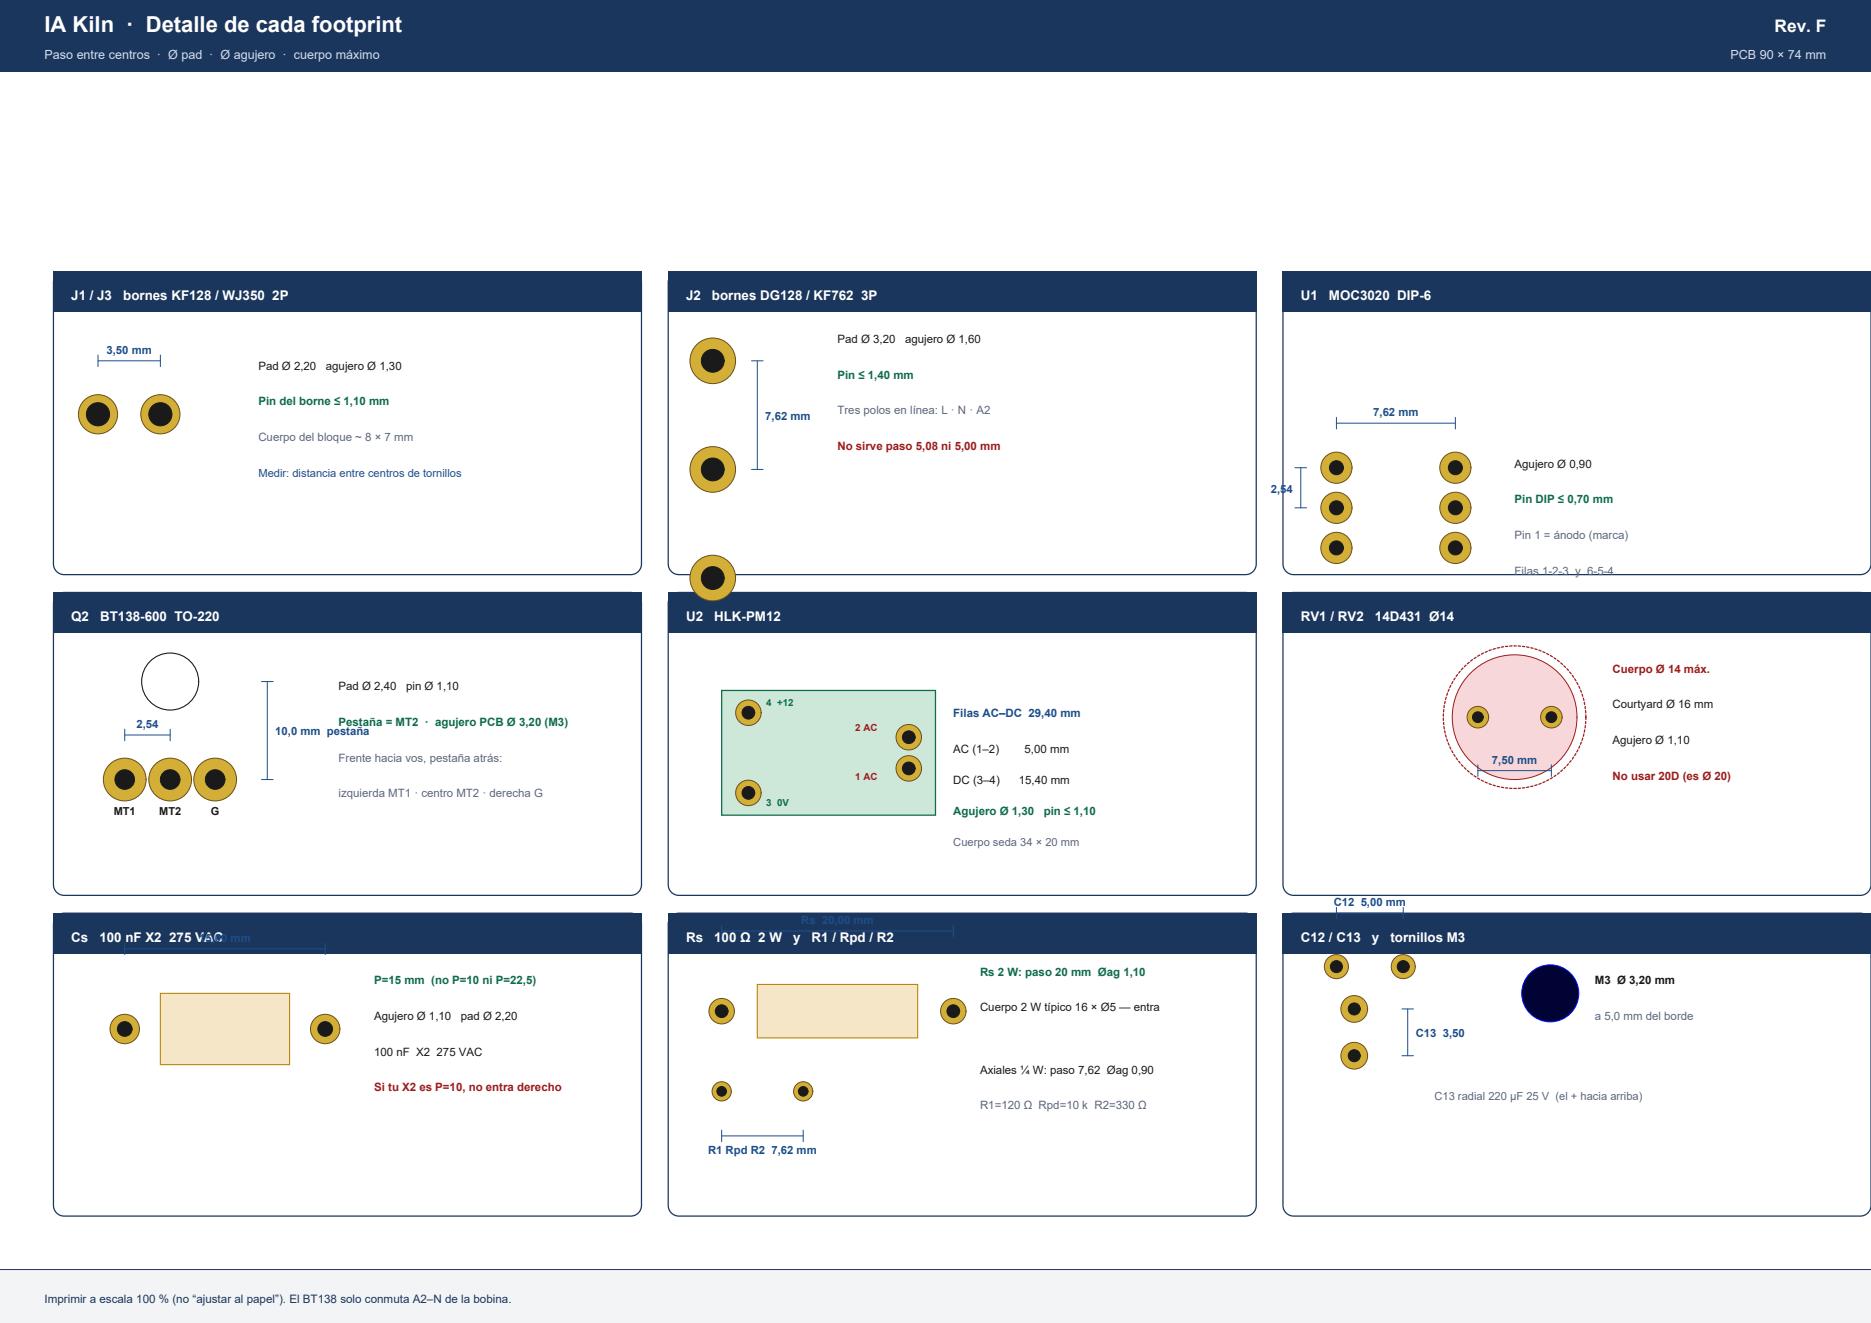
[picture p58: page 2]

Paso entre centros · Ø pad · Ø agujero · cuerpo máximo

Pin del borne ≤ 1,10 mm

Tres polos en línea: L · N · A2

Cuerpo del bloque ~ 8 × 7 mm

No sirve paso 5,08 ni 5,00 mm

Medir: distancia entre centros de tornillos

Filas AC–DC 29,40 mm

Frente hacia vos, pestaña atrás:

Rs 2 W: paso 20 mm Øag 1,10

Si tu X2 es P=10, no entra derecho

C13 radial 220 µF 25 V (el + hacia arriba)

# IA Kiln · Plantilla 1:1 · apoyar las piezas

## Checklist rápido

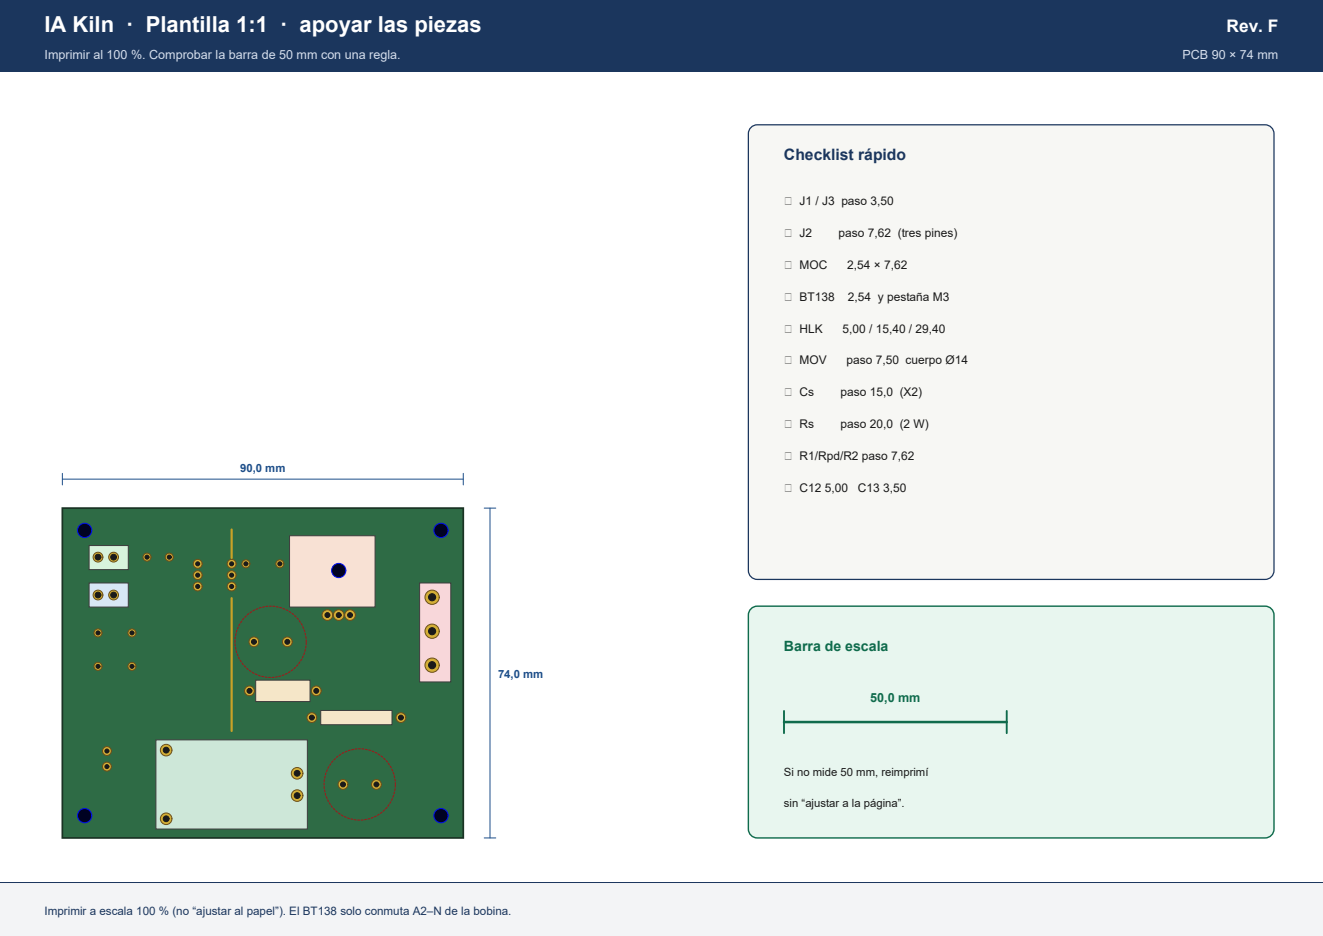
[picture p59: page 3]
 J1 / J3 paso 3,50; paso 7,62 (tres pines);  MOC;  BT138 2,54 y pestaña M3;  HLK;  MOV; paso 7,50 cuerpo Ø14; paso 15,0 (X2); paso 20,0 (2 W);  R1/Rpd/R2 paso 7,62

Imprimir al 100 %. Comprobar la barra de 50 mm con una regla.

Barra de escala

Si no mide 50 mm, reimprimí

sin “ajustar a la página”.
