praimondo1970-MyGit/SmartKiln-Firmware/docs/IA_Kiln_Driver_Cotas_2026-09-06.pdf

# IA Kiln · Cotas medidas del archivo EasyEDA

## EasyEDA 2026-09-06

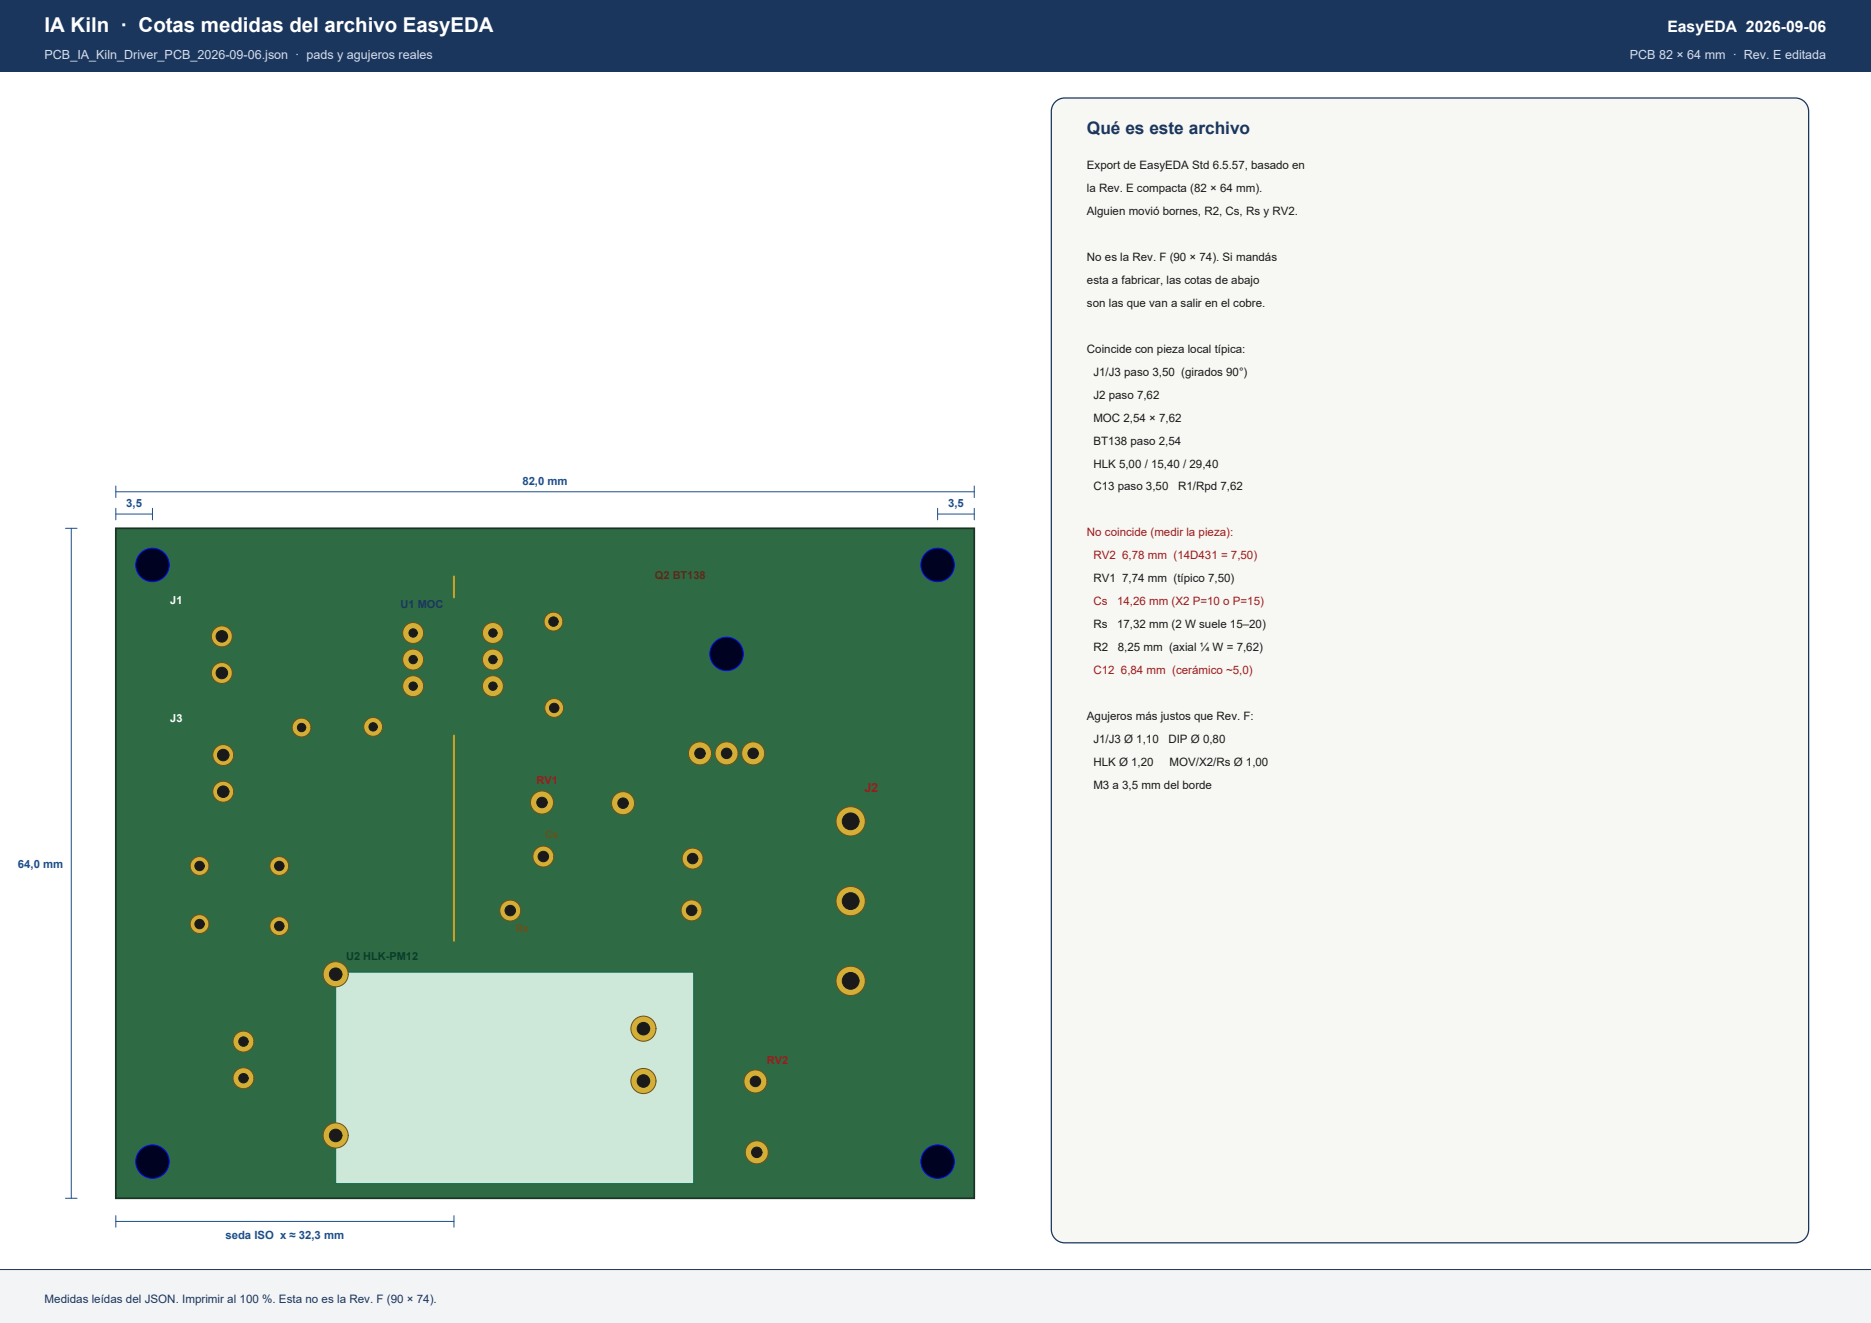
[picture p60: page 1]

PCB_IA_Kiln_Driver_PCB_2026-09-06.json · pads y agujeros reales

PCB 82 × 64 mm · Rev. E editada

Qué es este archivo

Export de EasyEDA Std 6.5.57, basado en

la Rev. E compacta (82 × 64 mm).

Alguien movió bornes, R2, Cs, Rs y RV2.

No es la Rev. F (90 × 74). Si mandás

esta a fabricar, las cotas de abajo

son las que van a salir en el cobre.

Coincide con pieza local típica:

No coincide (medir la pieza):

Agujeros más justos que Rev. F:

Medidas leídas del JSON. Imprimir al 100 %. Esta no es la Rev. F (90 × 74).

# IA Kiln · Detalle medido · 2026-09-06

Paso real vs pieza local típica

Ref | Paso en ESTA placa | Ø pad | Ø agujero | Pieza local típica | ¿Entra?
J1 / J3 | 3,50 mm (vertical) | 2,00 | 1,10 | KF128 / WJ350 P=3,50 pin ≤1,0 | Sí, bloque a 90°
J2 | 7,62 + 7,62 mm | 2,80 | 1,60 | DG128 / KF762 3P P=7,62 | Sí
U1 MOC3020 | 2,54 × 7,62 mm | 2,00 | 0,80 | DIP-6 pin ≤0,70 | Justo (mejor 0,90)
R2 330 Ω | 8,25 mm (vertical) | 1,80 | 0,90 | axial ¼ W P=7,62 o 10 | Hay que abrir patas
R1 / Rpd | 7,62 / 7,61 mm | 1,80 | 0,90 | axial ¼ W P=7,62 | Sí
Q2 BT138 | 2,54 + 2,54 mm | 2,20 | 1,00 | TO-220 paso 2,54 | Sí
pestaña | 9,50 mm a la fila | — | 3,20 (M3) | agujero tab ~Ø3,6 | Tornillo M3
U2 HLK-PM12 | AC 5,00 DC 15,40 | 2,40 | 1,20 | filas 29,40 pin ≤1,10 | Sí (agujero justo)
filas | 29,40 mm AC–DC | — | — | cuerpo ~34,8 × 20,2 | Seda 34,2 × 20,2
RV1 14D431 | 7,74 mm | 2,20 | 1,00 | Ø14 P=7,50 | Holgura 0,24 mm
RV2 14D431 | 6,78 mm (vertical) | 2,20 | 1,00 | Ø14 P=7,50 | NO: 0,72 mm corto
Cs X2 100 nF | 14,26 mm | 2,00 | 1,00 | P=10 o P=15 | P=15 apretado / P=10 no
Rs 100 Ω 2 W | 17,32 mm | 2,00 | 1,00 | cuerpo ~16 × Ø5 P=15–20 | Sí para 2 W
C12 100 nF | 6,84 mm | 1,80 | 0,80 | cerámico P=5,08 / 5,0 | Hay que abrir patas
C13 220 µF | 3,50 mm | 2,00 | 0,90 | radial P=3,5 o 5,0 | Sí si P=3,5
M3 (4×) | 3,50 mm al borde | — | 3,20 | tornillo M3 | Cerca del borde

### Antes de producir ESTE gerber

RV2 a 6,78 mm no acepta un 14D431 de 7,50 mm sin forzar. Cs a 14,26 mm no es P=10 ni P=15 limpio.

Si las piezas locales son las de la lista Rev. F, usá esa placa (90 × 74), no este JSON.

### Holgura de pin

Ø pin ≤ Ø agujero − 0,2 mm

DIP 0,80 y C12 0,80 son justos:

el esmalte del pin DIP a veces

no entra. Mejor 0,90 mm.

# IA Kiln · Plantilla 1:1 · archivo 2026-09-06

## Checklist de ESTA placa

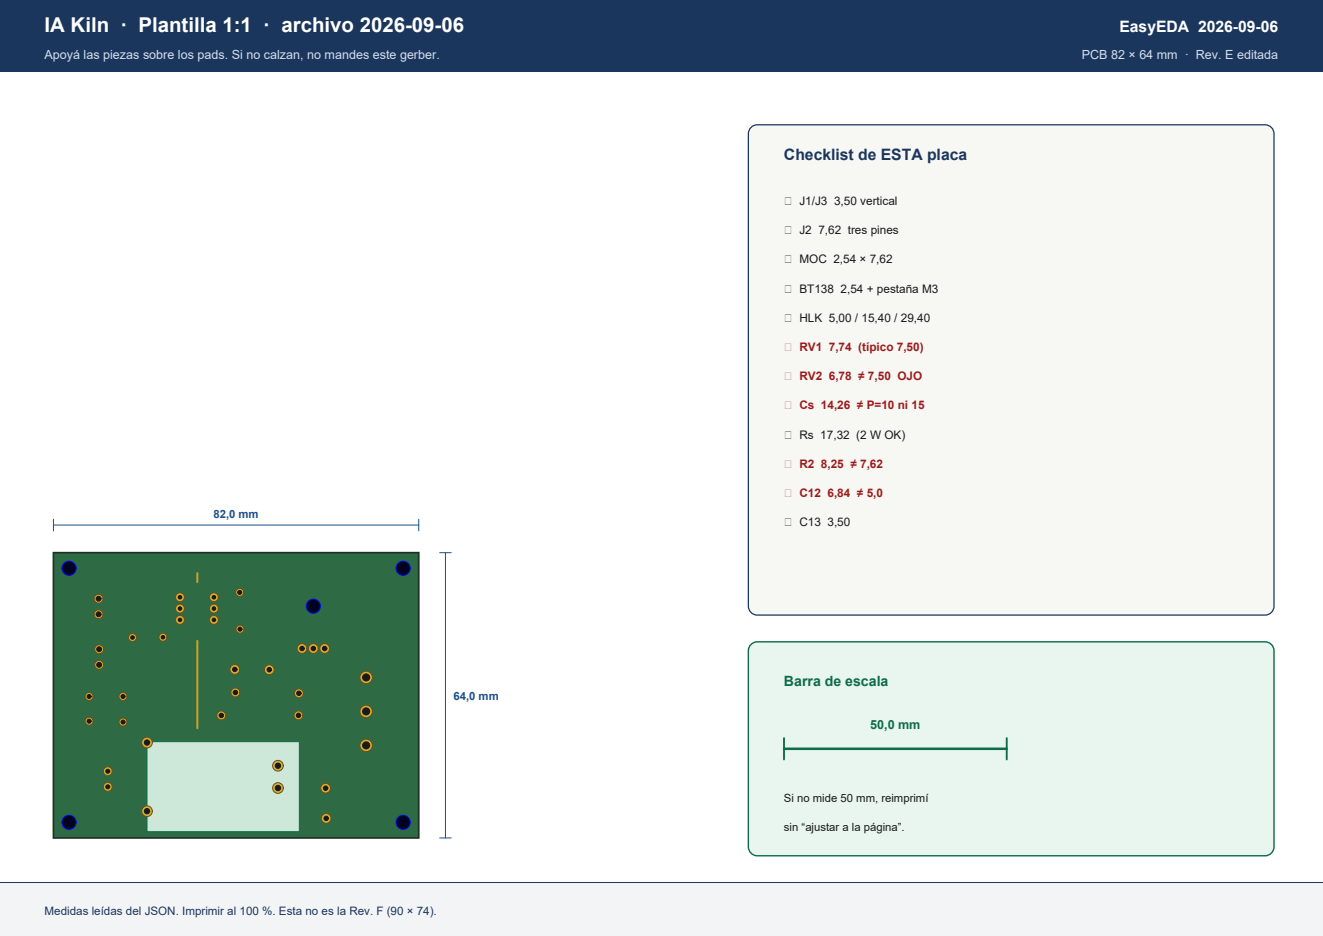
[picture p61: page 3]
 J1/J3 3,50 vertical;  J2 7,62 tres pines;  MOC 2,54 × 7,62;  BT138 2,54 + pestaña M3;  HLK 5,00 / 15,40 / 29,40;  RV1 7,74 (típico 7,50);  RV2 6,78 ≠ 7,50 OJO

Apoyá las piezas sobre los pads. Si no calzan, no mandes este gerber.

Barra de escala

Si no mide 50 mm, reimprimí

sin “ajustar a la página”.
