praimondo1970-MyGit/SmartKiln-Firmware/(list of files, drawings)

Other design files:
pcb/PCB_IA_Kiln_Driver_PCB_2026-09-06.json
