praimondo1970-MyGit/SmartKiln-Firmware/src/display_lvgl.cpp

#include "display_lvgl.h"
#include "display_icons.h"
#include "arc_grad_img.h"
#include "inter_fonts.h"
#include <Arduino_GFX_Library.h>
#include <freertos/FreeRTOS.h>
#include <freertos/queue.h>

// ---------- Pantalla principal ----------
static lv_obj_t* mainScreen = nullptr;

// Header
static lv_obj_t* imgLogo = nullptr;
static lv_obj_t* labelBrandSmart = nullptr;
static lv_obj_t* labelBrandKiln = nullptr;
static lv_obj_t* headerDivider = nullptr;
static lv_obj_t* headerKilnBlock = nullptr;
static lv_obj_t* labelKilnTitle = nullptr;
static lv_obj_t* labelDeviceId = nullptr;
static lv_obj_t* imgWifiIcon = nullptr;   // STA / internet
static lv_obj_t* imgSoftApIcon = nullptr; // SoftAP / hotspot

// Panel izquierdo: gauge + avance
static lv_obj_t* leftPanel = nullptr;
static lv_obj_t* arcTemp = nullptr;
static lv_obj_t* labelTempCaption = nullptr;
static lv_obj_t* labelTempValue = nullptr;
static lv_obj_t* labelTempUnit = nullptr;
static lv_obj_t* centerDivider = nullptr;
static lv_obj_t* labelRampCaption = nullptr;
static lv_obj_t* labelRampValue = nullptr;
static lv_obj_t* labelProgressCaption = nullptr;
static lv_obj_t* barCycleProgress = nullptr;
static lv_obj_t* labelProgressPct = nullptr;

// Panel derecho: tarjetas
static lv_obj_t* cardStatus = nullptr;
static lv_obj_t* labelStatusHeader = nullptr;
static lv_obj_t* statusPill = nullptr;
static lv_obj_t* labelStatusPill = nullptr;
static lv_obj_t* imgStatusFlame = nullptr;

static lv_obj_t* cardSummary = nullptr;
static lv_obj_t* labelSummaryHeader = nullptr;
static lv_obj_t* labelObjCaption = nullptr;
static lv_obj_t* labelObjValue = nullptr;
static lv_obj_t* labelStageCaption = nullptr;
static lv_obj_t* labelStageValue = nullptr;
static lv_obj_t* labelTimeCaption = nullptr;
static lv_obj_t* labelTimeValue = nullptr;
static lv_obj_t* imgObjIcon = nullptr;
static lv_obj_t* imgStageIcon = nullptr;
static lv_obj_t* imgTimeIcon = nullptr;

static lv_obj_t* cardProgram = nullptr;
static lv_obj_t* labelProgramHeader = nullptr;
static lv_obj_t* labelProgramValue = nullptr;

#define TFT_BL 2

Arduino_ESP32RGBPanel *rgbpanel = new Arduino_ESP32RGBPanel(
    40, 41, 39, 42,
    45, 48, 47, 21, 14,
    5, 6, 7, 15, 16, 4,
    8, 3, 46, 9, 1,
    0, 1, 1, 43,
    0, 3, 1, 12,
    1, 9000000
);

Arduino_RGB_Display *gfx = new Arduino_RGB_Display(
    480, 272, rgbpanel, 0, true
);

static lv_disp_draw_buf_t draw_buf;
static lv_color_t *disp_draw_buf = nullptr;
static lv_disp_drv_t disp_drv;
static bool displayInitialized = false;
static QueueHandle_t s_displayQueue = nullptr;
static lv_obj_t* bootScreen = nullptr;
static volatile bool s_requestMainUi = false;
static volatile bool s_mainUiReady = false;

static const lv_color_t COLOR_ORANGE = lv_color_hex(0xFF5722);
static const lv_color_t COLOR_ORANGE_DIM = lv_color_hex(0xD84315);
static const lv_color_t COLOR_ORANGE_REDDISH = lv_color_hex(0xC62828);
static const lv_color_t COLOR_ORANGE_LIGHT = lv_color_hex(0xFF8A65);
static const lv_color_t COLOR_GREEN = lv_color_hex(0x8BC34A);
static const lv_color_t COLOR_BLACK = lv_color_hex(0x000000);
static const lv_color_t COLOR_CARD = lv_color_hex(0x161616);
static const lv_color_t COLOR_CARD_BORDER = lv_color_hex(0x2E2E2E);
static const lv_color_t COLOR_DIVIDER_SOFT = lv_color_hex(0x3A3A3A);
static const lv_color_t COLOR_DARK_GRAY = lv_color_hex(0x404040);
/** Fondo de pista: herradura y barra de avance del ciclo. */
static const lv_color_t COLOR_TRACK_GRAY = lv_color_hex(0x2A2A2A);
static const lv_color_t COLOR_MID_GRAY = lv_color_hex(0x888888);
/** Iconos de red inactivos: gris más apagado que MID_GRAY (menos contraste). */
static const lv_color_t COLOR_ICON_OFF = lv_color_hex(0x3A3A3A);
static const lv_color_t COLOR_LIGHT_GRAY = lv_color_hex(0xB0B0B0);
static const lv_color_t COLOR_WHITE = lv_color_hex(0xFFFFFF);
static const lv_color_t COLOR_YELLOW = lv_color_hex(0xFFCC00);
static const lv_color_t COLOR_RED = lv_color_hex(0xFF4444);

static const int SCREEN_W = 480;
static const int SCREEN_H = 272;
static const int HEADER_H = 36;
static const int HEADER_KILN_MIN_W = 80;
static const int HEADER_KILN_GAP_TO_CONN = 8;
/** Espacio reservado a la derecha: wifi + SoftAP + márgenes. */
static const int HEADER_CONN_RESERVE_W = 52;
/** Posición X de fallback del bloque nombre (logo + SmartKiln + separador). */
static const int HEADER_KILN_NAME_X = 129;
static const int HEADER_BRAND_GAP = 10;
static const int CARD_RIGHT_MARGIN = 8;
static const int CARD_WIDTH_EXTRA = 15;  // ensancha tarjetas hacia la izquierda (herradura)
static const int CARD_CONTENT_PAD = 8;   // padding uniforme en las 3 tarjetas
static const int TEMP_ARC_MAX = 1000;
/** Herradura ~230° (+5° por lado); hueco centrado abajo (LVGL: 0° = 3 en punto). */
static const int ARC_SIZE = 222;
static const int ARC_SIDE_EXTEND_DEG = 5;
static const int ARC_SWEEP_DEG = 220 + 2 * ARC_SIDE_EXTEND_DEG;
static const int ARC_START_ANGLE = 90 + (360 - ARC_SWEEP_DEG) / 2;
static const int ARC_END_ANGLE = ARC_START_ANGLE + ARC_SWEEP_DEG;
static const int ARC_STROKE_W = 12;
/** Ancho del separador temp/rampa: casi todo el interior de la herradura. */
static const int CENTER_DIVIDER_TRIM = 44;
static const int CENTER_DIVIDER_W = ARC_SIZE - 2 * ARC_STROKE_W - CENTER_DIVIDER_TRIM;
static const int CENTER_DIVIDER_Y_EXTRA = 5;
/** Desplaza la herradura levemente hacia el borde inferior del panel. */
static const int ARC_Y_DOWN_BIAS = 8;
/** Desplaza la herradura hacia la izquierda (alejada de las tarjetas). */
static const int ARC_X_OFFSET = -13;
/** Desplaza el bloque central (caption/valor temp + rampa) respecto al arco. */
static const int ARC_CENTER_BLOCK_Y_OFFSET = -15;
/** Ajuste fino vertical de títulos/captions (CAPS). */
static const int CAPTION_Y_OFFSET = -1;
/** Solo el caption "TEMPERATURA" respecto al bloque central. */
static const int TEMP_CAPTION_Y_EXTRA = -23;
/** Solo el valor numérico de temperatura respecto al bloque central. */
static const int TEMP_VALUE_Y_EXTRA = -12;
/** Caption y valor de rampa respecto al bloque central (+ = hacia abajo). */
static const int RAMP_CAPTION_Y_EXTRA = 12;
static const int RAMP_VALUE_Y_EXTRA = 12;
static const int PROGRESS_BAR_WIDTH_TRIM = 61;  // leftW - trim = ancho barra avance
static const int PROGRESS_BAR_HEIGHT = 7;
/** Icono llama en pill HORNEANDO: zoom LVGL (256 = 100%). */
static const int STATUS_FLAME_ZOOM = 310;
static const int STATUS_FLAME_X_GAP = -12;
static const int STATUS_PILL_TEXT_X_OFFSET = 2;
static const int STATUS_PILL_HORNEANDO_TEXT_X_EXTRA = 5;
static const int SPLASH_SPINNER_Y = -34;
static const int SPLASH_SPINNER_SIZE = 88;
/** Halo naranja un poco más grande que el spinner (mockup inicio). */
static const int SPLASH_GLOW_OUTER_SIZE = 95;

static void createSplashGlowLayers(lv_obj_t* parent, lv_coord_t yOffset) {
    struct GlowLayer {
        lv_coord_t size;
        uint32_t color;
        lv_opa_t opa;
    };
    static const GlowLayer layers[] = {
        { 95, 0xFF5722, (lv_opa_t)3 },
        { 88, 0xF4511E, (lv_opa_t)4 },
        { 82, 0xF04B18, (lv_opa_t)5 },
        { 75, 0xE64A19, (lv_opa_t)6 },
        { 69, 0xDC4516, (lv_opa_t)7 },
        { 62, 0xD84315, (lv_opa_t)8 },
        { 56, 0xCB3310, (lv_opa_t)9 },
        { 49, 0xBF360C, (lv_opa_t)10 },
        { 43, 0xA52808, (lv_opa_t)11 },
        { 36, 0x5C1000, (lv_opa_t)12 },
    };

    for (size_t i = 0; i < sizeof(layers) / sizeof(layers[0]); i++) {
        lv_obj_t* glow = lv_obj_create(parent);
        lv_obj_set_size(glow, layers[i].size, layers[i].size);
        lv_obj_align(glow, LV_ALIGN_CENTER, 0, yOffset);
        lv_obj_set_style_radius(glow, LV_RADIUS_CIRCLE, LV_PART_MAIN);
        lv_obj_set_style_bg_color(glow, lv_color_hex(layers[i].color), LV_PART_MAIN);
        lv_obj_set_style_bg_opa(glow, layers[i].opa, LV_PART_MAIN);
        lv_obj_set_style_border_width(glow, 0, LV_PART_MAIN);
        lv_obj_clear_flag(glow, LV_OBJ_FLAG_SCROLLABLE);
    }
}

static void apply_horizontal_gradient(lv_obj_t* obj, lv_color_t from, lv_color_t to) {
    lv_obj_set_style_bg_color(obj, from, LV_PART_MAIN);
    lv_obj_set_style_bg_grad_color(obj, to, LV_PART_MAIN);
    lv_obj_set_style_bg_grad_dir(obj, LV_GRAD_DIR_HOR, LV_PART_MAIN);
    lv_obj_set_style_bg_opa(obj, LV_OPA_COVER, LV_PART_MAIN);
}

static void style_arc_track(lv_obj_t* arc) {
    lv_obj_set_style_pad_all(arc, 0, LV_PART_MAIN);
    lv_obj_set_style_pad_all(arc, 0, LV_PART_INDICATOR);
    lv_obj_set_style_pad_all(arc, 0, LV_PART_KNOB);

    lv_obj_set_style_arc_color(arc, COLOR_TRACK_GRAY, LV_PART_MAIN);
    lv_obj_set_style_arc_width(arc, ARC_STROKE_W, LV_PART_MAIN);
    lv_obj_set_style_arc_rounded(arc, true, LV_PART_MAIN);
    lv_obj_set_style_arc_opa(arc, LV_OPA_COVER, LV_PART_MAIN);

    lv_obj_set_style_arc_width(arc, ARC_STROKE_W, LV_PART_INDICATOR);
    lv_obj_set_style_arc_rounded(arc, true, LV_PART_INDICATOR);
    lv_obj_set_style_arc_opa(arc, LV_OPA_COVER, LV_PART_INDICATOR);
    lv_obj_set_style_arc_color(arc, COLOR_ORANGE, LV_PART_INDICATOR);
    lv_obj_set_style_arc_img_src(arc, &arc_grad_img, LV_PART_INDICATOR);

    lv_obj_clear_flag(arc, LV_OBJ_FLAG_CLICKABLE);
    lv_obj_set_style_bg_opa(arc, LV_OPA_TRANSP, LV_PART_KNOB);
    lv_obj_set_style_border_opa(arc, LV_OPA_TRANSP, LV_PART_KNOB);
    lv_obj_set_style_width(arc, 0, LV_PART_KNOB);
    lv_obj_set_style_height(arc, 0, LV_PART_KNOB);
}

static void formatDeviceId(char* out, size_t outLen, const char* deviceId) {
    if (deviceId == nullptr || deviceId[0] == '\0') {
        strncpy(out, "SK-001", outLen);
    } else {
        snprintf(out, outLen, "SK-%s", deviceId);
    }
    out[outLen - 1] = '\0';
}

static void apply_status_pill_style(const char* pillText) {
    if (statusPill == nullptr) return;

    if (strcmp(pillText, "HORNEANDO") == 0) {
        apply_horizontal_gradient(statusPill, COLOR_ORANGE, COLOR_ORANGE_REDDISH);
    } else if (strcmp(pillText, "PAUSADO") == 0) {
        lv_obj_set_style_bg_grad_dir(statusPill, LV_GRAD_DIR_NONE, LV_PART_MAIN);
        lv_obj_set_style_bg_color(statusPill, COLOR_YELLOW, LV_PART_MAIN);
    } else if (strcmp(pillText, "DETENIDO") == 0) {
        lv_obj_set_style_bg_grad_dir(statusPill, LV_GRAD_DIR_NONE, LV_PART_MAIN);
        lv_obj_set_style_bg_color(statusPill, COLOR_RED, LV_PART_MAIN);
    } else if (strcmp(pillText, "FINALIZADO") == 0) {
        lv_obj_set_style_bg_grad_dir(statusPill, LV_GRAD_DIR_NONE, LV_PART_MAIN);
        lv_obj_set_style_bg_color(statusPill, COLOR_GREEN, LV_PART_MAIN);
    } else if (strcmp(pillText, "INTERRUMPIDO") == 0) {
        apply_horizontal_gradient(statusPill, COLOR_ORANGE_DIM, COLOR_ORANGE);
    } else {
        lv_obj_set_style_bg_grad_dir(statusPill, LV_GRAD_DIR_NONE, LV_PART_MAIN);
        lv_obj_set_style_bg_color(statusPill, COLOR_DARK_GRAY, LV_PART_MAIN);
    }
}

static void placeSummaryColumn(lv_obj_t* caption, lv_obj_t* value,
                              int col, int colW, int capY, int valY) {
    const int x = col * colW;
    lv_obj_set_width(caption, colW);
    lv_obj_set_pos(caption, x, capY);
    lv_obj_set_style_text_align(caption, LV_TEXT_ALIGN_CENTER, LV_PART_MAIN);
    lv_obj_set_width(value, colW);
    lv_obj_set_pos(value, x, valY);
    lv_obj_set_style_text_align(value, LV_TEXT_ALIGN_CENTER, LV_PART_MAIN);
}

static lv_obj_t* createTintedIcon(lv_obj_t* parent, const lv_img_dsc_t* src, lv_color_t color) {
    lv_obj_t* img = lv_img_create(parent);
    lv_img_set_src(img, src);
    lv_obj_set_style_img_recolor(img, color, LV_PART_MAIN);
    lv_obj_set_style_img_recolor_opa(img, LV_OPA_COVER, LV_PART_MAIN);
    lv_obj_clear_flag(img, LV_OBJ_FLAG_CLICKABLE);
    return img;
}

static void setIconTint(lv_obj_t* img, lv_color_t color) {
    if (img != nullptr) {
        lv_obj_set_style_img_recolor(img, color, LV_PART_MAIN);
    }
}

static void styleCaption(lv_obj_t* label) {
    lv_obj_set_style_text_color(label, COLOR_MID_GRAY, LV_PART_MAIN);
    lv_obj_set_style_text_font(label, &inter_r10, LV_PART_MAIN);
    lv_obj_set_style_text_letter_space(label, 1, LV_PART_MAIN);
    lv_label_set_long_mode(label, LV_LABEL_LONG_CLIP);
}

static void styleSectionTitle(lv_obj_t* label) {
    styleCaption(label);
    lv_obj_set_style_text_letter_space(label, 1, LV_PART_MAIN);
}

/** Copia el nombre del horno; el recorte visual lo hace el label (LV_LABEL_LONG_DOT). */
static void formatHeaderKilnName(char* out, size_t outLen, const char* name) {
    if (outLen == 0) return;
    if (name == nullptr || name[0] == '\0') {
        strncpy(out, "Kiln 01", outLen);
        out[outLen - 1] = '\0';
        return;
    }
    strncpy(out, name, outLen);
    out[outLen - 1] = '\0';
}

static lv_coord_t calcHeaderKilnNameWidth() {
    lv_coord_t kilnLeft = HEADER_KILN_NAME_X;
    lv_coord_t connLeft = SCREEN_W - HEADER_CONN_RESERVE_W;

    if (mainScreen != nullptr && headerKilnBlock != nullptr && imgWifiIcon != nullptr) {
        lv_obj_update_layout(mainScreen);
        lv_coord_t measuredLeft = lv_obj_get_x(headerKilnBlock);
        lv_coord_t measuredConn = lv_obj_get_x(imgWifiIcon);
        if (measuredLeft > 0) kilnLeft = measuredLeft;
        if (measuredConn > kilnLeft + HEADER_KILN_MIN_W + HEADER_KILN_GAP_TO_CONN) {
            connLeft = measuredConn;
        }
    }

    lv_coord_t width = connLeft - kilnLeft - HEADER_KILN_GAP_TO_CONN;
    if (width < HEADER_KILN_MIN_W) {
        width = SCREEN_W - HEADER_CONN_RESERVE_W - HEADER_KILN_NAME_X - HEADER_KILN_GAP_TO_CONN;
    }
    return width;
}

static void layoutHeaderKilnNameBlock() {
    if (headerKilnBlock == nullptr || labelKilnTitle == nullptr) return;
    const lv_coord_t width = calcHeaderKilnNameWidth();
    lv_obj_set_width(headerKilnBlock, width);
    lv_obj_set_width(labelKilnTitle, width);
}

static void styleCard(lv_obj_t* card) {
    lv_obj_set_style_bg_color(card, COLOR_CARD, LV_PART_MAIN);
    lv_obj_set_style_bg_opa(card, LV_OPA_COVER, LV_PART_MAIN);
    lv_obj_set_style_radius(card, 10, LV_PART_MAIN);
    lv_obj_set_style_border_width(card, 1, LV_PART_MAIN);
    lv_obj_set_style_border_color(card, COLOR_CARD_BORDER, LV_PART_MAIN);
    lv_obj_set_style_pad_all(card, 8, LV_PART_MAIN);
    lv_obj_clear_flag(card, LV_OBJ_FLAG_SCROLLABLE);
}

static void styleValue(lv_obj_t* label, const lv_font_t* font) {
    lv_obj_set_style_text_color(label, COLOR_WHITE, LV_PART_MAIN);
    lv_obj_set_style_text_font(label, font, LV_PART_MAIN);
    lv_label_set_long_mode(label, LV_LABEL_LONG_CLIP);
}

void my_disp_flush(lv_disp_drv_t* disp, const lv_area_t* area, lv_color_t* color_p) {
    if (!area || !color_p || !disp) {
        if (disp) lv_disp_flush_ready(disp);
        return;
    }

    uint32_t w = (area->x2 - area->x1 + 1);
    uint32_t h = (area->y2 - area->y1 + 1);

    if (w == 0 || h == 0 || w > 480 || h > 272) {
        lv_disp_flush_ready(disp);
        return;
    }

    gfx->draw16bitRGBBitmap(area->x1, area->y1, (uint16_t *)&color_p->full, w, h);
    lv_disp_flush_ready(disp);
}

void my_touchpad_read(lv_indev_drv_t* indev_drv, lv_indev_data_t* data) {
    data->state = LV_INDEV_STATE_REL;
}

static void createBootSplash() {
    bootScreen = lv_obj_create(NULL);
    lv_obj_set_style_bg_color(bootScreen, COLOR_BLACK, LV_PART_MAIN);
    lv_obj_clear_flag(bootScreen, LV_OBJ_FLAG_SCROLLABLE);

    createSplashGlowLayers(bootScreen, SPLASH_SPINNER_Y);

    lv_obj_t* spinner = lv_spinner_create(bootScreen, 1000, 60);
    lv_obj_set_size(spinner, SPLASH_SPINNER_SIZE, SPLASH_SPINNER_SIZE);
    lv_obj_align(spinner, LV_ALIGN_CENTER, 0, SPLASH_SPINNER_Y);
    lv_obj_set_style_arc_color(spinner, COLOR_TRACK_GRAY, LV_PART_MAIN);
    lv_obj_set_style_arc_width(spinner, 6, LV_PART_MAIN);
    lv_obj_set_style_arc_color(spinner, COLOR_ORANGE, LV_PART_INDICATOR);
    lv_obj_set_style_arc_width(spinner, 6, LV_PART_INDICATOR);
    lv_obj_set_style_arc_rounded(spinner, true, LV_PART_INDICATOR);
    lv_obj_set_style_bg_opa(spinner, LV_OPA_TRANSP, LV_PART_MAIN);

    lv_obj_t* titleSmart = lv_label_create(bootScreen);
    lv_label_set_text(titleSmart, "Smart");
    lv_obj_set_style_text_color(titleSmart, COLOR_ORANGE, LV_PART_MAIN);
    lv_obj_set_style_text_font(titleSmart, &inter_sb18, LV_PART_MAIN);

    lv_obj_t* titleKiln = lv_label_create(bootScreen);
    lv_label_set_text(titleKiln, "Kiln");
    lv_obj_set_style_text_color(titleKiln, COLOR_WHITE, LV_PART_MAIN);
    lv_obj_set_style_text_font(titleKiln, &inter_sb18, LV_PART_MAIN);

    lv_obj_update_layout(bootScreen);
    const lv_coord_t smartW = lv_obj_get_width(titleSmart);
    const lv_coord_t kilnW = lv_obj_get_width(titleKiln);
    lv_obj_align(titleSmart, LV_ALIGN_CENTER, -(smartW + kilnW) / 4, 36);
    lv_obj_align_to(titleKiln, titleSmart, LV_ALIGN_OUT_RIGHT_MID, 0, 0);
    lv_obj_move_foreground(titleSmart);
    lv_obj_move_foreground(titleKiln);

    lv_obj_t* msg = lv_label_create(bootScreen);
    lv_label_set_text(msg, "Iniciando...");
    lv_obj_set_style_text_color(msg, COLOR_LIGHT_GRAY, LV_PART_MAIN);
    lv_obj_set_style_text_font(msg, &inter_r16, LV_PART_MAIN);
    lv_obj_align(msg, LV_ALIGN_CENTER, 0, 62);

    lv_scr_load(bootScreen);
}

static lv_obj_t* createSectionHeader(lv_obj_t* parent, const char* text, int x, int y) {
    lv_obj_t* label = lv_label_create(parent);
    lv_label_set_text(label, text);
    styleSectionTitle(label);
    lv_obj_set_pos(label, x, y + CAPTION_Y_OFFSET);
    return label;
}

void createUI() {
    mainScreen = lv_obj_create(NULL);
    lv_obj_set_style_bg_color(mainScreen, COLOR_CARD, LV_PART_MAIN);
    lv_obj_clear_flag(mainScreen, LV_OBJ_FLAG_SCROLLABLE);
    lv_scr_load(mainScreen);

    lv_obj_t* headerBar = lv_obj_create(mainScreen);
    lv_obj_set_size(headerBar, SCREEN_W, HEADER_H);
    lv_obj_set_pos(headerBar, 0, 0);
    lv_obj_set_style_bg_color(headerBar, COLOR_BLACK, LV_PART_MAIN);
    lv_obj_set_style_bg_opa(headerBar, LV_OPA_COVER, LV_PART_MAIN);
    lv_obj_set_style_border_width(headerBar, 0, LV_PART_MAIN);
    lv_obj_set_style_radius(headerBar, 0, LV_PART_MAIN);
    lv_obj_clear_flag(headerBar, LV_OBJ_FLAG_SCROLLABLE);

    imgLogo = createTintedIcon(mainScreen, &icon_flame, COLOR_ORANGE);
    lv_img_set_zoom(imgLogo, 300);
    lv_obj_set_pos(imgLogo, 6, 7);

    labelBrandSmart = lv_label_create(mainScreen);
    lv_label_set_text(labelBrandSmart, "Smart");
    lv_obj_set_style_text_color(labelBrandSmart, COLOR_ORANGE, LV_PART_MAIN);
    lv_obj_set_style_text_font(labelBrandSmart, &inter_sb18, LV_PART_MAIN);
    lv_obj_align_to(labelBrandSmart, imgLogo, LV_ALIGN_OUT_RIGHT_MID, 4, 0);

    labelBrandKiln = lv_label_create(mainScreen);
    lv_label_set_text(labelBrandKiln, "Kiln");
    lv_obj_set_style_text_color(labelBrandKiln, COLOR_WHITE, LV_PART_MAIN);
    lv_obj_set_style_text_font(labelBrandKiln, &inter_sb18, LV_PART_MAIN);
    lv_obj_align_to(labelBrandKiln, labelBrandSmart, LV_ALIGN_OUT_RIGHT_MID, 0, 0);

    headerDivider = lv_obj_create(mainScreen);
    lv_obj_set_size(headerDivider, 1, 22);
    lv_obj_set_style_bg_color(headerDivider, COLOR_MID_GRAY, LV_PART_MAIN);
    lv_obj_set_style_bg_opa(headerDivider, LV_OPA_60, LV_PART_MAIN);
    lv_obj_set_style_border_width(headerDivider, 0, LV_PART_MAIN);
    lv_obj_set_style_radius(headerDivider, 0, LV_PART_MAIN);
    lv_obj_clear_flag(headerDivider, LV_OBJ_FLAG_SCROLLABLE);
    lv_obj_align_to(headerDivider, labelBrandKiln, LV_ALIGN_OUT_RIGHT_MID, HEADER_BRAND_GAP, 0);

    headerKilnBlock = lv_obj_create(mainScreen);
    lv_obj_set_size(headerKilnBlock, HEADER_KILN_MIN_W, 28);
    lv_obj_set_style_bg_opa(headerKilnBlock, LV_OPA_TRANSP, LV_PART_MAIN);
    lv_obj_set_style_border_width(headerKilnBlock, 0, LV_PART_MAIN);
    lv_obj_set_style_pad_all(headerKilnBlock, 0, LV_PART_MAIN);
    lv_obj_clear_flag(headerKilnBlock, LV_OBJ_FLAG_SCROLLABLE);
    lv_obj_align_to(headerKilnBlock, headerDivider, LV_ALIGN_OUT_RIGHT_MID, HEADER_BRAND_GAP, 0);

    labelKilnTitle = lv_label_create(headerKilnBlock);
    lv_label_set_text(labelKilnTitle, "Kiln 01");
    lv_obj_set_style_text_color(labelKilnTitle, COLOR_WHITE, LV_PART_MAIN);
    lv_obj_set_style_text_font(labelKilnTitle, &inter_sb14, LV_PART_MAIN);
    lv_obj_set_pos(labelKilnTitle, 0, 0);
    lv_label_set_long_mode(labelKilnTitle, LV_LABEL_LONG_DOT);
    lv_obj_set_width(labelKilnTitle, HEADER_KILN_MIN_W);

    labelDeviceId = lv_label_create(headerKilnBlock);
    lv_label_set_text(labelDeviceId, "SK-001");
    lv_obj_set_style_text_color(labelDeviceId, COLOR_MID_GRAY, LV_PART_MAIN);
    lv_obj_set_style_text_font(labelDeviceId, &inter_r10, LV_PART_MAIN);
    lv_obj_set_pos(labelDeviceId, 0, 14);

    // WiFi (arco) = STA/internet; SoftAP (tethering) = red propia del horno.
    // Siempre visibles: blanco = activo, gris = inactivo (sin check ni texto).
    imgSoftApIcon = createTintedIcon(mainScreen, &icon_softap, COLOR_ICON_OFF);
    lv_obj_align(imgSoftApIcon, LV_ALIGN_TOP_RIGHT, -8, 9);

    imgWifiIcon = createTintedIcon(mainScreen, &icon_wifi, COLOR_ICON_OFF);
    lv_obj_align_to(imgWifiIcon, imgSoftApIcon, LV_ALIGN_OUT_LEFT_MID, -6, 0);
    layoutHeaderKilnNameBlock();

    // ---------- Panel izquierdo ----------
    const int leftW = 276;
    const int contentY = HEADER_H + 2;
    const int contentH = SCREEN_H - contentY - 8;

    leftPanel = lv_obj_create(mainScreen);
    lv_obj_set_size(leftPanel, leftW, contentH);
    lv_obj_set_pos(leftPanel, 6, contentY);
    lv_obj_set_style_bg_opa(leftPanel, LV_OPA_TRANSP, LV_PART_MAIN);
    lv_obj_set_style_border_width(leftPanel, 0, LV_PART_MAIN);
    lv_obj_set_style_pad_all(leftPanel, 0, LV_PART_MAIN);
    lv_obj_clear_flag(leftPanel, LV_OBJ_FLAG_SCROLLABLE);

    const int progressReserve = 44;
    const int arcZoneH = contentH - progressReserve;
    const int arcX = (leftW - ARC_SIZE) / 2 + ARC_X_OFFSET;
    int arcY = (arcZoneH > ARC_SIZE)
        ? (arcZoneH - ARC_SIZE) / 2 + ARC_Y_DOWN_BIAS
        : ARC_Y_DOWN_BIAS;

    arcTemp = lv_arc_create(leftPanel);
    lv_obj_set_size(arcTemp, ARC_SIZE, ARC_SIZE);
    lv_obj_set_pos(arcTemp, arcX, arcY);
    lv_arc_set_rotation(arcTemp, 0);
    lv_arc_set_bg_angles(arcTemp, ARC_START_ANGLE, ARC_END_ANGLE);
    lv_arc_set_range(arcTemp, 0, TEMP_ARC_MAX);
    lv_arc_set_value(arcTemp, 0);
    lv_arc_set_mode(arcTemp, LV_ARC_MODE_NORMAL);
    style_arc_track(arcTemp);

    labelTempCaption = lv_label_create(leftPanel);
    lv_label_set_text(labelTempCaption, "TEMPERATURA");
    styleCaption(labelTempCaption);
    lv_obj_align_to(labelTempCaption, arcTemp, LV_ALIGN_CENTER, 0,
        -26 + ARC_CENTER_BLOCK_Y_OFFSET + CAPTION_Y_OFFSET + TEMP_CAPTION_Y_EXTRA);

    labelTempValue = lv_label_create(leftPanel);
    lv_label_set_text(labelTempValue, "--");
    styleValue(labelTempValue, &inter_sb44);
    lv_obj_align_to(labelTempValue, arcTemp, LV_ALIGN_CENTER, -10,
        4 + ARC_CENTER_BLOCK_Y_OFFSET + TEMP_VALUE_Y_EXTRA);

    labelTempUnit = lv_label_create(leftPanel);
    lv_label_set_text(labelTempUnit, "\xC2\xB0""C");
    lv_obj_set_style_text_color(labelTempUnit, COLOR_WHITE, LV_PART_MAIN);
    lv_obj_set_style_text_font(labelTempUnit, &inter_r20, LV_PART_MAIN);
    lv_obj_align_to(labelTempUnit, labelTempValue, LV_ALIGN_OUT_RIGHT_BOTTOM, 2, -4);

    centerDivider = lv_obj_create(leftPanel);
    lv_obj_set_size(centerDivider, CENTER_DIVIDER_W, 1);
    lv_obj_set_style_bg_color(centerDivider, COLOR_DIVIDER_SOFT, LV_PART_MAIN);
    lv_obj_set_style_bg_opa(centerDivider, LV_OPA_COVER, LV_PART_MAIN);
    lv_obj_set_style_border_width(centerDivider, 0, LV_PART_MAIN);
    lv_obj_set_style_radius(centerDivider, 0, LV_PART_MAIN);
    lv_obj_clear_flag(centerDivider, LV_OBJ_FLAG_SCROLLABLE);
    lv_obj_align_to(centerDivider, arcTemp, LV_ALIGN_CENTER, 0,
        24 + ARC_CENTER_BLOCK_Y_OFFSET + CENTER_DIVIDER_Y_EXTRA);

    labelRampCaption = lv_label_create(leftPanel);
    lv_label_set_text(labelRampCaption, "VELOCIDAD DE ASCENSO");
    styleCaption(labelRampCaption);
    lv_obj_align_to(labelRampCaption, arcTemp, LV_ALIGN_CENTER, 0,
        34 + ARC_CENTER_BLOCK_Y_OFFSET + CAPTION_Y_OFFSET + RAMP_CAPTION_Y_EXTRA);

    labelRampValue = lv_label_create(leftPanel);
    lv_label_set_text(labelRampValue, "--\xC2\xB0""C/min");
    lv_obj_set_style_text_color(labelRampValue, COLOR_GREEN, LV_PART_MAIN);
    lv_obj_set_style_text_font(labelRampValue, &inter_r16, LV_PART_MAIN);
    lv_obj_align_to(labelRampValue, arcTemp, LV_ALIGN_CENTER, 0, 52 + ARC_CENTER_BLOCK_Y_OFFSET + RAMP_VALUE_Y_EXTRA);

    labelProgressCaption = lv_label_create(leftPanel);
    lv_label_set_text(labelProgressCaption, "AVANCE DEL CICLO");
    styleCaption(labelProgressCaption);
    lv_obj_set_pos(labelProgressCaption, 8, contentH - 34 + CAPTION_Y_OFFSET);

    barCycleProgress = lv_bar_create(leftPanel);
    lv_obj_set_size(barCycleProgress, leftW - PROGRESS_BAR_WIDTH_TRIM, PROGRESS_BAR_HEIGHT);
    lv_obj_set_pos(barCycleProgress, 8, contentH - 18);
    lv_bar_set_range(barCycleProgress, 0, 100);
    lv_bar_set_value(barCycleProgress, 0, LV_ANIM_OFF);
    lv_obj_set_style_bg_color(barCycleProgress, COLOR_TRACK_GRAY, LV_PART_MAIN);
    lv_obj_set_style_bg_opa(barCycleProgress, LV_OPA_COVER, LV_PART_MAIN);
    lv_obj_set_style_radius(barCycleProgress, 4, LV_PART_MAIN);
    lv_obj_set_style_bg_color(barCycleProgress, COLOR_ORANGE, LV_PART_INDICATOR);
    lv_obj_set_style_bg_opa(barCycleProgress, LV_OPA_COVER, LV_PART_INDICATOR);
    lv_obj_set_style_radius(barCycleProgress, 4, LV_PART_INDICATOR);

    labelProgressPct = lv_label_create(leftPanel);
    lv_label_set_text(labelProgressPct, "0%");
    lv_obj_set_style_text_color(labelProgressPct, COLOR_ORANGE, LV_PART_MAIN);
    lv_obj_set_style_text_font(labelProgressPct, &inter_r14, LV_PART_MAIN);
    lv_obj_align_to(labelProgressPct, barCycleProgress, LV_ALIGN_OUT_RIGHT_MID, 6, 0);

    // ---------- Panel derecho: 3 tarjetas apiladas ----------
    const int rightX = 288 - CARD_WIDTH_EXTRA;
    const int rightW = SCREEN_W - rightX - CARD_RIGHT_MARGIN;
    const int barBottomY = contentY + contentH - 8;
    const int CARD_GAP = 8;
    const int CARD_H_PROGRAM = 47;
    const int CARD_H_SUMMARY = 84;
    const int cardProgramY = barBottomY - CARD_H_PROGRAM;
    const int cardSummaryY = cardProgramY - CARD_GAP - CARD_H_SUMMARY;
    const int CARD_H_STATUS = cardSummaryY - CARD_GAP - contentY;

    cardStatus = lv_obj_create(mainScreen);
    lv_obj_set_size(cardStatus, rightW, CARD_H_STATUS);
    lv_obj_set_pos(cardStatus, rightX, contentY);
    styleCard(cardStatus);
    lv_obj_set_style_pad_all(cardStatus, CARD_CONTENT_PAD, LV_PART_MAIN);
    labelStatusHeader = createSectionHeader(cardStatus, "ESTADO ACTUAL", 0, 0);

    statusPill = lv_obj_create(cardStatus);
    lv_obj_set_size(statusPill, rightW - 2 * CARD_CONTENT_PAD, 32);
    lv_obj_set_pos(statusPill, 0, 18);
    apply_horizontal_gradient(statusPill, COLOR_ORANGE_LIGHT, COLOR_ORANGE);
    lv_obj_set_style_radius(statusPill, 14, LV_PART_MAIN);
    lv_obj_set_style_border_width(statusPill, 0, LV_PART_MAIN);
    lv_obj_clear_flag(statusPill, LV_OBJ_FLAG_SCROLLABLE);

    labelStatusPill = lv_label_create(statusPill);
    lv_label_set_text(labelStatusPill, "INACTIVO");
    lv_obj_set_style_text_color(labelStatusPill, COLOR_WHITE, LV_PART_MAIN);
    lv_obj_set_style_text_font(labelStatusPill, &inter_sb14, LV_PART_MAIN);
    lv_obj_set_style_text_letter_space(labelStatusPill, 2, LV_PART_MAIN);
    lv_obj_align(labelStatusPill, LV_ALIGN_CENTER, STATUS_PILL_TEXT_X_OFFSET, 0);

    imgStatusFlame = createTintedIcon(statusPill, &icon_flame, COLOR_WHITE);
    lv_img_set_zoom(imgStatusFlame, STATUS_FLAME_ZOOM);
    lv_obj_align_to(imgStatusFlame, labelStatusPill, LV_ALIGN_OUT_LEFT_MID, STATUS_FLAME_X_GAP, 0);
    lv_obj_add_flag(imgStatusFlame, LV_OBJ_FLAG_HIDDEN);

    cardSummary = lv_obj_create(mainScreen);
    lv_obj_set_size(cardSummary, rightW, CARD_H_SUMMARY);
    lv_obj_set_pos(cardSummary, rightX, cardSummaryY);
    styleCard(cardSummary);
    lv_obj_set_style_pad_all(cardSummary, CARD_CONTENT_PAD, LV_PART_MAIN);
    labelSummaryHeader = createSectionHeader(cardSummary, "RESUMEN DEL CICLO", 0, 0);

    const int colW = (rightW - 16) / 3;
    const int summaryDividerY = 14;
    const int summaryDividerH = CARD_H_SUMMARY - summaryDividerY - 10;
    for (int d = 1; d <= 2; d++) {
        lv_obj_t* divider = lv_obj_create(cardSummary);
        lv_obj_set_size(divider, 1, summaryDividerH);
        lv_obj_set_pos(divider, d * colW, summaryDividerY);
        lv_obj_set_style_bg_color(divider, COLOR_DIVIDER_SOFT, LV_PART_MAIN);
        lv_obj_set_style_bg_opa(divider, LV_OPA_COVER, LV_PART_MAIN);
        lv_obj_set_style_border_width(divider, 0, LV_PART_MAIN);
        lv_obj_set_style_radius(divider, 0, LV_PART_MAIN);
        lv_obj_clear_flag(divider, LV_OBJ_FLAG_SCROLLABLE);
        lv_obj_clear_flag(divider, LV_OBJ_FLAG_CLICKABLE);
    }

    labelObjCaption = lv_label_create(cardSummary);
    lv_label_set_text(labelObjCaption, "OBJETIVO");
    styleCaption(labelObjCaption);

    labelObjValue = lv_label_create(cardSummary);
    lv_label_set_text(labelObjValue, "--");
    styleValue(labelObjValue, &inter_r14);

    labelStageCaption = lv_label_create(cardSummary);
    lv_label_set_text(labelStageCaption, "ETAPA");
    styleCaption(labelStageCaption);

    labelStageValue = lv_label_create(cardSummary);
    lv_label_set_text(labelStageValue, "--");
    styleValue(labelStageValue, &inter_r14);

    labelTimeCaption = lv_label_create(cardSummary);
    lv_label_set_text(labelTimeCaption, "TIEMPO");
    styleCaption(labelTimeCaption);

    labelTimeValue = lv_label_create(cardSummary);
    lv_label_set_text(labelTimeValue, "--");
    styleValue(labelTimeValue, &inter_r14);

    placeSummaryColumn(labelObjCaption, labelObjValue, 0, colW, 16 + CAPTION_Y_OFFSET, 30);
    placeSummaryColumn(labelStageCaption, labelStageValue, 1, colW, 16 + CAPTION_Y_OFFSET, 30);
    placeSummaryColumn(labelTimeCaption, labelTimeValue, 2, colW, 16 + CAPTION_Y_OFFSET, 30);

    imgObjIcon = createTintedIcon(cardSummary, &icon_target, COLOR_ORANGE);
    lv_obj_align_to(imgObjIcon, labelObjValue, LV_ALIGN_OUT_BOTTOM_MID, 0, 4);

    imgStageIcon = createTintedIcon(cardSummary, &icon_stairs, COLOR_ORANGE);
    lv_obj_align_to(imgStageIcon, labelStageValue, LV_ALIGN_OUT_BOTTOM_MID, 0, 4);

    imgTimeIcon = createTintedIcon(cardSummary, &icon_clock, COLOR_ORANGE);
    lv_obj_align_to(imgTimeIcon, labelTimeValue, LV_ALIGN_OUT_BOTTOM_MID, 0, 4);

    cardProgram = lv_obj_create(mainScreen);
    lv_obj_set_size(cardProgram, rightW, CARD_H_PROGRAM);
    lv_obj_set_pos(cardProgram, rightX, cardProgramY);
    styleCard(cardProgram);
    lv_obj_set_style_pad_all(cardProgram, CARD_CONTENT_PAD, LV_PART_MAIN);
    labelProgramHeader = createSectionHeader(cardProgram, "PROGRAMA ACTUAL", 0, 0);

    labelProgramValue = lv_label_create(cardProgram);
    lv_label_set_text(labelProgramValue, "--");
    lv_obj_set_style_text_color(labelProgramValue, COLOR_WHITE, LV_PART_MAIN);
    lv_obj_set_style_text_font(labelProgramValue, &inter_r14, LV_PART_MAIN);
    lv_obj_set_pos(labelProgramValue, 0, 16);
    lv_label_set_long_mode(labelProgramValue, LV_LABEL_LONG_DOT);
    lv_obj_set_width(labelProgramValue, rightW - 2 * CARD_CONTENT_PAD);
}

bool initDisplayLVGL() {
    gfx->begin();
    gfx->fillScreen(0x0000);

    pinMode(TFT_BL, OUTPUT);
    digitalWrite(TFT_BL, HIGH);

    int w = gfx->width();
    int h = gfx->height();
    if (w == 0 || h == 0) {
        return false;
    }

    lv_init();

    uint32_t buffer_size = w * h / 8;
#ifdef ESP32
    disp_draw_buf = (lv_color_t *)heap_caps_malloc(sizeof(lv_color_t) * buffer_size, MALLOC_CAP_INTERNAL | MALLOC_CAP_8BIT);
#else
    disp_draw_buf = (lv_color_t *)malloc(sizeof(lv_color_t) * buffer_size);
#endif

    if (!disp_draw_buf) {
        return false;
    }

    lv_disp_draw_buf_init(&draw_buf, disp_draw_buf, NULL, buffer_size);

    lv_disp_drv_init(&disp_drv);
    disp_drv.hor_res = w;
    disp_drv.ver_res = h;
    disp_drv.flush_cb = my_disp_flush;
    disp_drv.draw_buf = &draw_buf;
    if (!lv_disp_drv_register(&disp_drv)) {
        return false;
    }

    createBootSplash();
    lv_timer_handler();

    s_displayQueue = xQueueCreate(1, sizeof(DisplayData));
    if (s_displayQueue == nullptr) {
        Serial.println("[DISPLAY] ERROR: cola display no creada");
        return false;
    }

    s_requestMainUi = false;
    s_mainUiReady = false;
    displayInitialized = true;
    Serial.println("[DISPLAY] Splash de arranque activo");
    return true;
}

void display_requestMainUi() {
    if (!displayInitialized || s_mainUiReady) {
        return;
    }
    s_requestMainUi = true;
}

bool display_isMainUiReady() {
    return s_mainUiReady;
}

void display_postData(const DisplayData& data) {
    if (s_displayQueue == nullptr || !s_mainUiReady) {
        return;
    }
    xQueueOverwrite(s_displayQueue, &data);
}

void displayTaskHandler(void *pvParameters) {
    DisplayData pending;
    for (;;) {
        if (s_requestMainUi && !s_mainUiReady) {
            createUI();
            if (bootScreen != nullptr) {
                lv_obj_del(bootScreen);
                bootScreen = nullptr;
            }
            s_mainUiReady = true;
            s_requestMainUi = false;
            Serial.println("[DISPLAY] UI principal lista (V2 dashboard)");
        }

        lv_timer_handler();

        if (s_mainUiReady) {
            while (s_displayQueue != nullptr &&
                   xQueueReceive(s_displayQueue, &pending, 0) == pdTRUE) {
                updateDisplayData(pending);
            }
        }

        vTaskDelay(pdMS_TO_TICKS(5));
    }
}

static int computeCycleProgressPct(const DisplayData& data) {
    if (data.totalMinutes > 0 && data.elapsedMinutes >= 0) {
        int pct = (data.elapsedMinutes * 100) / data.totalMinutes;
        if (pct < 0) pct = 0;
        if (pct > 100) pct = 100;
        return pct;
    }
    if (data.totalStages > 0 && data.currentStage > 0) {
        int pct = ((data.currentStage - 1) * 100) / data.totalStages;
        if (pct < 0) pct = 0;
        if (pct > 100) pct = 100;
        return pct;
    }
    return 0;
}

static void formatRemainingTime(char* out, size_t outLen, int minutes) {
    if (minutes < 0) {
        strncpy(out, "--", outLen);
        out[outLen - 1] = '\0';
        return;
    }
    const int hours = minutes / 60;
    const int mins = minutes % 60;
    if (hours > 0) {
        snprintf(out, outLen, "%dh %02dm", hours, mins);
    } else {
        snprintf(out, outLen, "%dm", mins);
    }
}

void updateDisplayData(const DisplayData& data) {
    if (!displayInitialized || !s_mainUiReady) {
        return;
    }

    // Velocidad de ascenso: rampa programada del segmento (no lectura de termocupla)
    if (labelRampValue != nullptr) {
        char rampStr[20];
        const bool activeRun = (strcmp(data.status, "CALENTANDO") == 0 ||
                                strcmp(data.status, "PAUSADO") == 0 ||
                                strcmp(data.status, "INTERRUMPIDO") == 0);

        if (activeRun && strcmp(data.currentPhase, "REMOJO") == 0) {
            snprintf(rampStr, sizeof(rampStr), "0\xC2\xB0""C/min");
            lv_obj_set_style_text_color(labelRampValue, COLOR_MID_GRAY, LV_PART_MAIN);
        } else if (activeRun && strcmp(data.currentPhase, "RAMPA") == 0 &&
                   data.stageRampCpm > -0.5f) {
            snprintf(rampStr, sizeof(rampStr), "%+.0f\xC2\xB0""C/min", data.stageRampCpm);
            lv_obj_set_style_text_color(labelRampValue,
                data.stageRampCpm > 0.0f ? COLOR_GREEN : lv_color_hex(0x66AAFF), LV_PART_MAIN);
        } else {
            strncpy(rampStr, "--\xC2\xB0""C/min", sizeof(rampStr));
            lv_obj_set_style_text_color(labelRampValue, COLOR_MID_GRAY, LV_PART_MAIN);
        }
        lv_label_set_text(labelRampValue, rampStr);
    }
    if (labelKilnTitle != nullptr) {
        char title[64];
        formatHeaderKilnName(title, sizeof(title), data.kilnName);
        lv_label_set_text(labelKilnTitle, title);
    }
    if (labelDeviceId != nullptr) {
        char idBuf[20];
        formatDeviceId(idBuf, sizeof(idBuf), data.deviceId);
        lv_label_set_text(labelDeviceId, idBuf);
    }

    // Iconos de red siempre visibles: blanco = activo, gris = inactivo.
    const bool softApOn = data.connection.softApAvailable;
    const bool internetOn =
        data.connection.wifiConnected || data.connection.firebaseConnected;

    if (imgSoftApIcon != nullptr) {
        lv_obj_clear_flag(imgSoftApIcon, LV_OBJ_FLAG_HIDDEN);
        setIconTint(imgSoftApIcon, softApOn ? COLOR_WHITE : COLOR_ICON_OFF);
        lv_obj_align(imgSoftApIcon, LV_ALIGN_TOP_RIGHT, -8, 9);
    }
    if (imgWifiIcon != nullptr) {
        lv_obj_clear_flag(imgWifiIcon, LV_OBJ_FLAG_HIDDEN);
        setIconTint(imgWifiIcon, internetOn ? COLOR_WHITE : COLOR_ICON_OFF);
        if (imgSoftApIcon != nullptr) {
            lv_obj_align_to(imgWifiIcon, imgSoftApIcon, LV_ALIGN_OUT_LEFT_MID, -6, 0);
        } else {
            lv_obj_align(imgWifiIcon, LV_ALIGN_TOP_RIGHT, -8, 9);
        }
    }
    layoutHeaderKilnNameBlock();

    // Gauge de temperatura (escala 0–1000 °C)
    if (arcTemp != nullptr) {
        int arcVal = (int)data.currentTemp;
        if (arcVal < 0) arcVal = 0;
        if (arcVal > TEMP_ARC_MAX) arcVal = TEMP_ARC_MAX;
        lv_arc_set_value(arcTemp, arcVal);
    }
    if (labelTempValue != nullptr) {
        char tempStr[12];
        snprintf(tempStr, sizeof(tempStr), "%.0f", data.currentTemp);
        lv_label_set_text(labelTempValue, tempStr);
        if (arcTemp != nullptr) {
            lv_obj_align_to(labelTempValue, arcTemp, LV_ALIGN_CENTER, -10,
                4 + ARC_CENTER_BLOCK_Y_OFFSET + TEMP_VALUE_Y_EXTRA);
        }
        if (labelTempUnit != nullptr && labelTempValue != nullptr) {
            lv_obj_align_to(labelTempUnit, labelTempValue, LV_ALIGN_OUT_RIGHT_BOTTOM, 2, -4);
        }
    }

    // Barra de avance del ciclo
    const int progressPct = computeCycleProgressPct(data);
    if (barCycleProgress != nullptr) {
        lv_bar_set_value(barCycleProgress, progressPct, LV_ANIM_OFF);
    }
    if (labelProgressPct != nullptr) {
        char pctStr[8];
        snprintf(pctStr, sizeof(pctStr), "%d%%", progressPct);
        lv_label_set_text(labelProgressPct, pctStr);
    }

    // Estado (pill)
    if (labelStatusPill != nullptr && statusPill != nullptr) {
        const char* pillText = "INACTIVO";

        if (strcmp(data.status, "CALENTANDO") == 0) {
            pillText = "HORNEANDO";
        } else if (strcmp(data.status, "PAUSADO") == 0) {
            pillText = "PAUSADO";
        } else if (strcmp(data.status, "DETENIDO") == 0) {
            pillText = "DETENIDO";
        } else if (strcmp(data.status, "FINALIZADO") == 0) {
            pillText = "FINALIZADO";
        } else if (strcmp(data.status, "INTERRUMPIDO") == 0) {
            pillText = "INTERRUMPIDO";
        }

        lv_label_set_text(labelStatusPill, pillText);
        apply_status_pill_style(pillText);

        const int pillTextX = (strcmp(pillText, "HORNEANDO") == 0)
            ? STATUS_PILL_TEXT_X_OFFSET + STATUS_PILL_HORNEANDO_TEXT_X_EXTRA
            : STATUS_PILL_TEXT_X_OFFSET;
        lv_obj_align(labelStatusPill, LV_ALIGN_CENTER, pillTextX, 0);

        if (imgStatusFlame != nullptr) {
            const bool showFlame = (strcmp(pillText, "HORNEANDO") == 0);
            if (showFlame) {
                lv_obj_clear_flag(imgStatusFlame, LV_OBJ_FLAG_HIDDEN);
                setIconTint(imgStatusFlame, COLOR_WHITE);
                lv_obj_align_to(imgStatusFlame, labelStatusPill, LV_ALIGN_OUT_LEFT_MID, STATUS_FLAME_X_GAP, 0);
            } else {
                lv_obj_add_flag(imgStatusFlame, LV_OBJ_FLAG_HIDDEN);
            }
        }
    }

    // Resumen del ciclo
    if (labelObjValue != nullptr) {
        if (data.targetTemp > 0.0f) {
            char buf[16];
            snprintf(buf, sizeof(buf), "%.0f\xC2\xB0""C", data.targetTemp);
            lv_label_set_text(labelObjValue, buf);
        } else {
            lv_label_set_text(labelObjValue, "--");
        }
    }
    if (labelStageValue != nullptr) {
        if (data.currentStage > 0 && data.totalStages > 0) {
            char buf[16];
            snprintf(buf, sizeof(buf), "%d/%d", data.currentStage, data.totalStages);
            lv_label_set_text(labelStageValue, buf);
        } else {
            lv_label_set_text(labelStageValue, "--");
        }
    }
    if (labelTimeValue != nullptr) {
        int minutesToShow = -1;
        if (data.remainingMinutes >= 0) {
            minutesToShow = data.remainingMinutes;
        } else if (data.totalMinutes > 0) {
            minutesToShow = data.totalMinutes;
        }
        char timeStr[16];
        formatRemainingTime(timeStr, sizeof(timeStr), minutesToShow);
        lv_label_set_text(labelTimeValue, timeStr);
    }

    // Programa
    if (labelProgramValue != nullptr) {
        if (strlen(data.programName) > 0) {
            lv_label_set_text(labelProgramValue, data.programName);
        } else {
            lv_label_set_text(labelProgramValue, "--");
        }
    }

    lv_refr_now(lv_disp_get_default());
}
