praimondo1970-MyGit/SmartKiln-Firmware/src/kiln_commands.cpp

#include "kiln_commands.h"
#include "kiln_shared.h"
#include "wifi_manager.h"
#include "kiln_firing_firebase.h"
#include <ArduinoJson.h>

extern void kiln_notifyLocalSessionComplete();

// Helpers de persistencia del estado de ejecución (run_state). Definidos
// en main.cpp; los declaramos aquí para poder grabar / borrar el estado
// cuando llegan los comandos START / PAUSE / STOP / RESUME.
extern void saveRunState(const String& estado,
                         int segmentIdx,
                         const String& phase,
                         unsigned long soakAccumMs,
                         float tempSnapshot);
extern void clearRunState();
extern volatile int runCurrentSegment;
extern String runCurrentPhase;
extern volatile unsigned long runSoakAccumMs;
extern volatile bool resumeFromSavedState;
// offlineOnly / wifi* vía kiln_shared.h
extern bool wifiConnected;
extern bool firebaseConnected;

String kiln_buildStatusJson() {
    StaticJsonDocument<640> doc;
    if (xSemaphoreTake(xMutex, pdMS_TO_TICKS(200)) == pdTRUE) {
        doc["temperature"] = temperaturaActual;
        doc["status"] = estadoHorno;
        doc["programName"] = curvaActual.recibida ? curvaActual.nombre : "";
        doc["numStages"] = curvaActual.recibida ? curvaActual.numSegmentos : 0;
        doc["profileLoaded"] = curvaActual.recibida;
        doc["programDurationMin"] = programTotalDurationMinutes;
        int elapsedMin = 0;
        int remainingMin = 0;
        if (programStartTime > 0) {
            unsigned long elapsedMs = millis() - programStartTime;
            if (programPauseTime > 0 && estadoHorno == "PAUSADO") {
                elapsedMs = programPauseTime - programStartTime;
            }
            elapsedMin = (int)(elapsedMs / 60000UL);
            remainingMin = programTotalDurationMinutes - elapsedMin;
            if (remainingMin < 0) {
                remainingMin = 0;
            }
        }
        doc["elapsedMinutes"] = elapsedMin;
        doc["remainingMinutes"] = remainingMin;
        int stageForApi = 0;
        if (curvaActual.recibida && curvaActual.numSegmentos > 0) {
            const bool activeRun = (estadoHorno == "CALENTANDO" ||
                                    estadoHorno == "PAUSADO" ||
                                    estadoHorno == "INTERRUMPIDO");
            if (activeRun && runCurrentSegment >= 0 &&
                runCurrentSegment < curvaActual.numSegmentos) {
                stageForApi = runCurrentSegment + 1;
            }
        }
        doc["currentStage"] = stageForApi;
        doc["type"] = "KILN";
        doc["resetReason"] = g_lastResetReason;
        doc["resetCode"] = g_lastResetCode;
        doc["bootCount"] = g_bootCount;
        if (g_prevResetReason.length() > 0) {
            doc["prevResetReason"] = g_prevResetReason;
        }
        xSemaphoreGive(xMutex);
    } else {
        doc["error"] = "mutex_timeout";
    }
    String out;
    serializeJson(doc, out);
    return out;
}

String kiln_buildInfoJson() {
    StaticJsonDocument<448> doc;
    if (xSemaphoreTake(xMutex, pdMS_TO_TICKS(200)) == pdTRUE) {
        doc["name"] = kilnName;
        doc["model"] = kilnModel;
        doc["volume"] = kilnVolume;
        doc["userId"] = userId;
        doc["macAddress"] = deviceMacAddress;
        doc["type"] = "KILN";
        doc["offlineOnly"] = offlineOnly;
        doc["resetReason"] = g_lastResetReason;
        doc["resetCode"] = g_lastResetCode;
        doc["bootCount"] = g_bootCount;
        xSemaphoreGive(xMutex);
    }
    String out;
    serializeJson(doc, out);
    return out;
}

String kiln_buildApInfoJson() {
    StaticJsonDocument<256> doc;
    doc["ssid"] = wifi_manager_apSsid();
    doc["password"] = wifi_manager_apPassword();
    doc["url"] = "http://192.168.4.1";
    doc["apiStatus"] = "http://192.168.4.1/api/status";
    String out;
    serializeJson(doc, out);
    return out;
}

String kiln_processCommand(const String& cmdRaw) {
    String cmd = cmdRaw;
    cmd.trim();
    StaticJsonDocument<128> resp;

    if (cmd.length() == 0) {
        resp["ok"] = false;
        resp["error"] = "empty_command";
        String out;
        serializeJson(resp, out);
        return out;
    }

    if (xSemaphoreTake(xMutex, pdMS_TO_TICKS(500)) != pdTRUE) {
        resp["ok"] = false;
        resp["error"] = "mutex_timeout";
        String out;
        serializeJson(resp, out);
        return out;
    }

    if (cmd == "START") {
        estadoHorno = "CALENTANDO";
        // START nuevo: siempre segmento 0 (RESUME retoma run_state guardado).
        runCurrentSegment = 0;
        runCurrentPhase = "RAMPA";
        runSoakAccumMs = 0;
        resumeFromSavedState = false;
        if (programPauseTime > 0) {
            unsigned long pauseDuration = millis() - programPauseTime;
            programStartTime += pauseDuration;
            programPauseTime = 0;
        } else if (programStartTime == 0 && curvaActual.recibida && curvaActual.numSegmentos > 0) {
            float currentTemp = temperaturaActual;
            int totalDuration = calculateProgramTotalDuration(currentTemp);
            programStartTime = millis();
            programTotalDurationMinutes = totalDuration;
            kilnFiringBegin(
                deviceMacAddress,
                String(curvaActual.nombre),
                kilnName,
                currentTemp,
                curvaActual.segmentos,
                curvaActual.numSegmentos
            );
        }
        saveRunState("CALENTANDO", 0, "RAMPA", 0UL, temperaturaActual);
        Serial.println("[API] START");
    } else if (cmd == "PAUSE") {
        estadoHorno = "PAUSADO";
        programPauseTime = millis();
        // Importante: en PAUSADO también queremos que un corte de luz
        // detecte interrupción. Reescribimos run_state con el estado nuevo
        // pero conservando segIdx / phase / soakMs.
        saveRunState("PAUSADO",
                     runCurrentSegment >= 0 ? (int)runCurrentSegment : 0,
                     runCurrentPhase.length() > 0 ? runCurrentPhase : String("RAMPA"),
                     runSoakAccumMs,
                     temperaturaActual);
        Serial.println("[API] PAUSE");
    } else if (cmd == "RESUME") {
        // RESUME se usa para retomar después de INTERRUMPIDO. La diferencia
        // con START es que TaskControlCurva tiene que arrancar desde el
        // segmento/fase guardados, no desde cero. resumeFromSavedState ya
        // está en true porque loadRunState() lo dejó así al boot; acá solo
        // cambiamos el estado a CALENTANDO y la tarea hace el resto.
        estadoHorno = "CALENTANDO";
        programPauseTime = 0;
        // Persistir ya como CALENTANDO (no dejar INTERRUMPIDO en NVS/RTDB).
        saveRunState("CALENTANDO",
                     runCurrentSegment >= 0 ? (int)runCurrentSegment : 0,
                     runCurrentPhase.length() > 0 ? runCurrentPhase : String("RAMPA"),
                     runSoakAccumMs,
                     temperaturaActual);
        Serial.println("[API] RESUME");
    } else if (cmd == "STOP") {
        estadoHorno = "IDLE";
        programStartTime = 0;
        kilnFiringRequestFinalize(false);
        programPauseTime = 0;
        // STOP cancela definitivamente: borramos el run_state para que un
        // reinicio futuro no levante INTERRUMPIDO.
        clearRunState();
        Serial.println("[API] STOP → IDLE");
    } else if (cmd == "TEST") {
        resp["ok"] = true;
        resp["message"] = "TEST_OK";
        xSemaphoreGive(xMutex);
        String out;
        serializeJson(resp, out);
        return out;
    } else if (cmd == "STATUS") {
        xSemaphoreGive(xMutex);
        return kiln_buildStatusJson();
    } else {
        resp["ok"] = false;
        resp["error"] = "unknown_command";
        resp["cmd"] = cmd;
        xSemaphoreGive(xMutex);
        String out;
        serializeJson(resp, out);
        return out;
    }

    xSemaphoreGive(xMutex);
    resp["ok"] = true;
    resp["cmd"] = cmd;
    resp["status"] = estadoHorno;
    if (cmd == "START" || cmd == "PAUSE" || cmd == "STOP" || cmd == "RESUME") {
        // Publicar estado ya para que la app no lea el valor viejo en RTDB tras handoff.
        kiln_tryPublishStatusNow(estadoHorno.c_str());
        kiln_onLocalSessionEnd(cmd.c_str());
    }
    String out;
    serializeJson(resp, out);
    return out;
}

bool kiln_loadProfileJson(const String& jsonStr, String& errorOut) {
    // Programas con varias etapas + programUpdatedAt superan fácilmente 512 B
    // de capacidad ArduinoJson (no es el tamaño del string, son slots internos).
    DynamicJsonDocument doc(3072);
    DeserializationError error = deserializeJson(doc, jsonStr);
    if (error) {
        errorOut = error.c_str();
        return false;
    }

    if (xSemaphoreTake(xMutex, pdMS_TO_TICKS(5000)) != pdTRUE) {
        errorOut = "mutex_timeout";
        return false;
    }

    // No permitir cambiar programa mientras hornea o está en pausa.
    if (estadoHorno == "CALENTANDO" || estadoHorno == "PAUSADO") {
        xSemaphoreGive(xMutex);
        errorOut = (estadoHorno == "PAUSADO") ? "busy_paused" : "busy_baking";
        Serial.printf("[API] Perfil rechazado: estado=%s\n", estadoHorno.c_str());
        return false;
    }

    memset(&curvaActual, 0, sizeof(CurvaActiva));
    const char* nombre = doc["nombre"] | "SIN_NOMBRE";
    strncpy(curvaActual.nombre, nombre, sizeof(curvaActual.nombre) - 1);

    int numSeg = doc["numSeg"] | 0;
    curvaActual.numSegmentos = min(numSeg, 10);
    for (int i = 0; i < curvaActual.numSegmentos; i++) {
        curvaActual.segmentos[i].tempObjetivo = doc["seg"][i]["temp"] | 0;
        curvaActual.segmentos[i].rampaCporMin = doc["seg"][i]["rampa"] | 0;
        curvaActual.segmentos[i].tiempoRemojoMin = doc["seg"][i]["remojo"] | 0;
    }
    curvaActual.recibida = true;

    const unsigned long updatedAtFromApp = doc["programUpdatedAt"] | 0UL;
    kiln_onProfileLoaded(updatedAtFromApp);

    float currentTempForDuration = 25.0f;
    if (temperaturaActual > 0) {
        currentTempForDuration = temperaturaActual;
    }
    programTotalDurationMinutes = calculateProgramTotalDuration(currentTempForDuration);
    xSemaphoreGive(xMutex);

    saveProfile();
    Serial.printf("[API] Perfil cargado: %s (%d seg) estado=%s\n",
                  curvaActual.nombre, curvaActual.numSegmentos, estadoHorno.c_str());
    // No liberar SoftAP aquí: kiln_api debe responder HTTP primero.
    return true;
}

bool kiln_applyKilnInfoJson(const String& jsonStr, String& errorOut) {
    StaticJsonDocument<512> doc;
    DeserializationError error = deserializeJson(doc, jsonStr);
    if (error) {
        errorOut = error.c_str();
        return false;
    }

    if (xSemaphoreTake(xMutex, pdMS_TO_TICKS(500)) != pdTRUE) {
        errorOut = "mutex_timeout";
        return false;
    }

    kilnName = doc["name"] | "Sin Nombre";
    kilnModel = doc["model"] | "Sin Modelo";
    kilnVolume = doc["volume"] | 0.0;
    userId = doc["userId"] | "";
    const bool wasOfflineOnly = offlineOnly;
    offlineOnly = doc["offlineOnly"] | false;
    pendingKilnInfoSave = true;
    needsDeviceInfoUpdate = true;

    bool wifiCredsUpdated = false;
    JsonVariantConst wifiCfg = doc["wifi"];
    if (!offlineOnly && !wifiCfg.isNull()) {
        String newSsid = wifiCfg["ssid"] | "";
        String newPassword = wifiCfg["password"] | "";
        if (newSsid.length() > 0) {
            wifiSSID = newSsid;
            wifiPassword = newPassword;
            wifiConfigReceived = true;
            wifiCredsUpdated = true;
            needsWifiReconnect = true;
            pendingWifiConfigSave = true;
        }
    }

    if (offlineOnly) {
        // Solo local: cortar STA/Firebase; SoftAP sticky.
        needsWifiReconnect = false;
        wifiConnected = false;
        firebaseConnected = false;
        wifi_manager_disconnectStaKeepAp();
        Serial.println("[API] offlineOnly=1 — SoftAP sticky, sin STA/Firebase");
    } else {
        // Online: STA vía ciclo SoftAP release (beginStaToHome), NO reconnectToWifi
        // completo — pelea con AP off y deja BearSSL en LoadProhibited (visto en log).
        if (wifiSSID.length() > 0) {
            wifiConfigReceived = true;
            if (wifiCredsUpdated && !wasOfflineOnly) {
                needsWifiReconnect = true;
            } else {
                needsWifiReconnect = false;
            }
            Serial.printf("[API] offlineOnly=0 — STA pendiente hacia '%s'%s\n",
                          wifiSSID.c_str(),
                          wasOfflineOnly ? " (via AP release)" : "");
        } else {
            Serial.println("[API] offlineOnly=0 — sin credenciales STA; SoftAP sigue sticky");
        }
        // Salida de Solo local: liberar SoftAP aunque Firebase aún no esté OK
        // (si no, nunca se suelta el AP ni arranca la caza STA).
        if (wasOfflineOnly) {
            wifi_manager_armApReleaseWithoutFirebaseOnce();
        }
    }
    xSemaphoreGive(xMutex);
    Serial.printf("[API] kiln-info aplicado (offlineOnly=%d)\n", offlineOnly ? 1 : 0);
    return true;
}

void kiln_onLocalSessionEnd(const char* reason) {
    Serial.printf("[API] Fin sesion local (%s)\n", reason ? reason : "?");
    wifi_manager_requestApRelease();
    kiln_notifyLocalSessionComplete();
}
