praimondo1970-MyGit/SmartKiln-Firmware/include/display_icons.h

#ifndef DISPLAY_ICONS_H
#define DISPLAY_ICONS_H

#include <lvgl.h>

/* Material Symbols Rounded (filled), white + alpha for img_recolor. */
LV_IMG_DECLARE(icon_wifi);
LV_IMG_DECLARE(icon_softap);
LV_IMG_DECLARE(icon_cloud);
LV_IMG_DECLARE(icon_flame);
LV_IMG_DECLARE(icon_target);
LV_IMG_DECLARE(icon_stairs);
LV_IMG_DECLARE(icon_clock);

#endif
