praimondo1970-MyGit/SmartKiln-Firmware/include/inter_fonts.h

#ifndef INTER_FONTS_H
#define INTER_FONTS_H

#include <lvgl.h>

/* Inter (SIL OFL) — bitmap bpp 4, generadas con lv_font_conv desde Fontsource. */
LV_FONT_DECLARE(inter_r10);
LV_FONT_DECLARE(inter_r12);
LV_FONT_DECLARE(inter_r14);
LV_FONT_DECLARE(inter_r16);
LV_FONT_DECLARE(inter_r20);
LV_FONT_DECLARE(inter_sb14);
LV_FONT_DECLARE(inter_sb18);
LV_FONT_DECLARE(inter_sb44);

#endif
