praimondo1970-MyGit/SmartKiln-Firmware/include/icon_bluetooth_24.h

#ifndef ICON_BLUETOOTH_24_H
#define ICON_BLUETOOTH_24_H

// Incluir display_lvgl.h que ya tiene las definiciones de LVGL
#include "display_lvgl.h"

// Declaración externa del icono de Bluetooth
extern const lv_img_dsc_t icon_bluetooth_24;

#endif // ICON_BLUETOOTH_24_H
