praimondo1970-MyGit/SmartKiln-Firmware/sim/include/display_icons.h

#ifndef DISPLAY_ICONS_H
#define DISPLAY_ICONS_H

#include <lvgl.h>

/* Material Symbols Rounded (filled), white + alpha for image_recolor. */
LV_IMAGE_DECLARE(icon_wifi);
LV_IMAGE_DECLARE(icon_cloud);
LV_IMAGE_DECLARE(icon_flame);
LV_IMAGE_DECLARE(icon_target);
LV_IMAGE_DECLARE(icon_stairs);
LV_IMAGE_DECLARE(icon_clock);

#endif
