praimondo1970-MyGit/SmartKiln-Firmware/(commit log)

2026-05-21 Add full project baseline (platformio, lib, docs).
    [app_logo.xml]
2026-05-25 Stabilize WiFi/AP transitions and Firebase reliability
    - Move TaskComunicaciones to Core 1 to avoid contention with the
    WiFi event task on Core 0 (was causing Task WDT timeouts during
    AP/STA radio transitions).
    - Increase Task WDT timeout to 30 s and disable panic on timeout so
    blocking Firebase operations fail by timeout instead of rebooting.
    - Recycle the FirebaseData object on every AP/STA radio transition
    to guarantee a clean BearSSL context (br_ssl_engine_flush() was
    hanging when reusing a dirty session).
    - Tighten AP release timings to reduce local-command -> Firebase
    update latency from ~25 s to ~5-7 s:
    AP_RELEASE_GRACE_MS : 2500 -> 1200 ms
    AP_RELEASE_FORCE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
    [kiln_api.cpp, kiln_api.h, kiln_commands.cpp, kiln_commands.h, wifi_manager.cpp]
2026-05-28 Persist run state to NVS and add INTERRUMPIDO/RESUME with boot IDLE sync.
    Save program progress across power loss, resume from saved segment/phase,
    publish real status to Firebase on boot, and map INTERRUMPIDO on the display.
2026-09-07 Cursor: Apply local changes for cloud agent
    [PCB_IA_Kiln_Driver_PCB_2026-09-06.json, SmartKiln_Caja.FCStd, SmartKiln_Fondo.step, SmartKiln_Fondo.stl, SmartKiln_Frente.step, SmartKiln_Frente.stl]
2026-09-07 Add driver Rev. F component BOM spreadsheet.
    Shopping list for the PCB, panel, ESP supply, and mechanics.
    [IA_Kiln_Driver_BOM.xlsx]
